ZaphodBytebrox/open-rc-car/docs/anforderungen/karosseriehalter-rammschutz.md

# Anforderungen: Karosseriehalter und Rammschutz

- **Kürzel:** KRS
- **Domäne:** Mechanik
- **Status:** umgesetzt (MECH-KRS-013: Soll vom Nutzer auf ≤ 175 g angehoben; offen nur 🔧 Prototyp)
- **Stand:** 2026-11-13

## Zweck
Vorne und hinten schützt ein Rammschutz Grundplatte, Dämpfer und Querlenkerlaschen bei Frontal- und Heckstößen. Er besteht aus einem steifen Träger aus PC und einem weichen TPU-Puffer davor. Die Puffer laufen unten schräg aus und dienen so auch als Unterfahrschutz für die flache Grundplatte. Auf den Plattenenden sitzen Karosseriepfosten mit Klammern für die Lexan-Karosserie **Neo Scorcher** aus dem TT-02B-Bausatz. Alle Teile nutzen nur die Lochbilder, die Grundplatte und Oberdeck (Fassung 2) auf den Plattenverlängerungen festgelegt haben.

**Meilenstein:** Rammschutz und Karosseriehalter sind konstruiert, in Fusion kollisionsfrei mit Rädern (Federweg, Lenkeinschlag), Dämpfern und Aufhängung und als Druckteile exportiert. Nach Lieferung des Bausatzes werden die Befestigungspunkte und die Höhe der Karosserie gemessen und die Pfosten gegebenenfalls neu gedruckt.

## Schnittstellen
| Zu | Art | Beschreibung |
|---|---|---|
| Skelett (`skelett.md`, Design „open-rc-car-skelett“, aktuelle Version) | mechanisch | Parameter und Hüllkörper per Ableiten: `radstand` 266, `achse_x` 133, Bewegungsräume der Räder `fahrwerk-radraum-*` (vorne X 79,5…186,5 / Y ±71,5…±140,2 mit Lenkeinschlag), `bodenfreiheit` 25, `plattenstaerke` 4 |
| Grundplatte und Oberdeck (`grundplatte-oberdeck.md`, Design „open-rc-car-grundplatte“, **Version 12** aus PR #13) | mechanisch | Plattenenden X ±177 (`gp_ueberstand` 20 mm über die Getriebe hinaus, Nutzerentscheidung 2026-11-13). Eine Lochreihe bei **X ±169,35** (`gp_ende_loch_x`): **Rammschutz** je 2 × M3 an Y ±8 (`gp_ramm_y`), **Karosseriehalter** je 2 × M3 an Y ±22 (`gp_karo_y`). Die Lochachsen liegen 6,85 mm vor bzw. hinter den Dämpferbrücken und 7,65 mm vom Plattenende. Bohrungen Ø 3,2 mit Senkung unten, Senkkopfschrauben von unten, Gewinde im aufgesetzten Teil (Gewindeeinsätze wie Pos. 30). Plattenunterseite Z 25, Oberseite Z 29, Plattenende ±46 mm breit. Alle 8 Löcher eines Endes liegen auf einer X-Linie: Ein Träger braucht für Stoß- und Kippmomente eine Abstützung, z. B. an der Plattenstirn (bis X ±177) oder über alle 4 Löcher (die Dämpferbrücken dürfen nicht berührt werden, MECH-KRS-004). |
| Vorderachse (`vorderachse.md`, Design „open-rc-car-vorderachse“ **v8**) | mechanisch | Die Dämpferbrücke vorne (X 156,5…162,5, ab Z 31) liegt hinter der Lochreihe. Davor liegen die Dämpfer (X 163…181, Y ±37…±59, Z 36…96) und die Querlenkerlaschen bis X 168,5 (Querlenker ab \|Y\| 31,5). Die Sturzstangen liegen bei X 139…150,5, Z 66…87. |
| Hinterachse (`hinterachse.md`, Design „open-rc-car-hinterachse“ v14) | mechanisch | Die Dämpferbrücke hinten (X −162,5…−156,5, Y ±58,7, Z 31…109) liegt vor der Lochreihe. Die Dämpfer (X −176…−156, \|Y\| 44…77, Z 26…109) reichen fast bis zum Plattenende. Halter dürfen die Brücken nicht berühren und müssen neben den Dämpfern bleiben. |
| Karosserie Neo Scorcher (Bausatz 58568) | mechanisch | Lexan-Karosserie aus dem Bausatz, Fahrzeug 380 × 250 mm. Lage und Höhe der Befestigungslöcher sind vorläufig (aus der Bauanleitung) und werden nach Lieferung gemessen. Die Karosserieklammern stammen aus dem Bausatz. |

## Anforderungen
| ID | Priorität | Anforderung | Abnahmekriterium |
|---|---|---|---|
| MECH-KRS-001 | MUSS | Eigenes Fusion-Design „open-rc-car-karosseriehalter-rammschutz“ im Projekt „open-rc-car“, abgeleitet vom Skelett, von der Grundplatte und (für die Prüfung) von Vorder- und Hinterachse. Neue Maße sind Benutzerparameter mit Präfix `kr_` und Kommentar (Quelle, „belegt“, „vorläufig“ oder „abgeleitet“). Alle Karosseriemaße (Lochabstand, Höhe und Lage der Befestigungspunkte vorne und hinten) und die Maße der Klammern sind eigene Parameter. | Parameterliste in Fusion, jeder Parameter mit Kommentar; Skizzen voll bestimmt. Test: `radstand` im Skelett auf 280 mm → Ableitungen aktualisieren ohne Fehler, die Teile folgen den Lochbildern, danach zurück auf 266 mm. Dafür darf das Skelett als zwei neue Versionen gespeichert werden (280 mm, danach wieder 266 mm, maßgleich mit dem Stand davor), wie bei der Hinterachse. |
| MECH-KRS-002 | MUSS | **Rammschutz vorne und hinten** (Nutzerentscheidung 2026-11-10), je aus einem **Träger** aus Prusament PC (PETG für den Test) und einem **Puffer** aus TPU davor. Der Träger sitzt auf dem Rammschutz-Lochbild (±169,35 / ±8) und darf zusätzlich das Karosseriehalter-Lochbild (±169,35 / ±22) nutzen, mit Gewindeeinsätzen. Der Puffer ist am Träger befestigt (verschraubt oder formschlüssig), ohne Gewindeeinsätze im TPU. | Modell: 2 Träger, 2 Puffer auf den Lochbildern, Lochmitten gemessen. Befestigung des Puffers im Schnittbild gezeigt. |
| MECH-KRS-003 | MUSS | **Schutzwirkung:** In der Draufsicht liegen die Dämpfer und Querlenkerlaschen der jeweiligen Achse innerhalb der Pufferbreite. Die Stoßfläche des Puffers liegt **≥ 5 mm vor** (bzw. hinter) allen anderen Teilen des Fahrzeugs außer den Rädern. **Gesamtlänge** über beide Puffer ≤ 380 mm (wie das Neo-Scorcher-Fahrzeug). | Gemessen in Fusion: X der Stoßflächen, X der vordersten bzw. hintersten übrigen Teile, Pufferbreite in Y gegenüber den Dämpfern, Gesamtlänge. |
| MECH-KRS-004 | MUSS | **Kollisionsfreiheit:** Rammschutz und Karosseriepfosten kollidieren nicht mit den Bewegungsräumen der Räder (Federweg, vorne mit vollem Lenkeinschlag), den Dämpfern über den Federweg, Querlenkern, Dämpferbrücken, Sturzstangen und der Lenkung. Die Dämpferbrücken werden nicht berührt. | Interferenz ↔ Skelett, Grundplatte, Vorderachse, Hinterachse: 0 außer an den gewollten Auflageflächen auf der Grundplatte. Mindestabstand ≥ 3 mm zu den Bewegungsräumen der Räder und ≥ 1 mm zu allen anderen Teilen, gemessen und dokumentiert. |
| MECH-KRS-005 | MUSS | **Unterfahrschutz** (Nutzerentscheidung 2026-11-10): Die Puffer laufen unten als Anfahrschräge aus und decken die Stirnkante der Grundplatte vorne bzw. hinten ab, damit das Auto über Kanten gleitet. Kein eigenes Teil unter der Platte. Der tiefste Punkt liegt **nicht unter Z 25** (Bodenfreiheit bleibt erhalten). Schräge ≥ 30° zur Waagerechten. | Gemessen: tiefster Punkt der Puffer Z ≥ 25,0. Winkel der Schräge, Abdeckung der Plattenstirnkante im Schnittbild. |
| MECH-KRS-006 | MUSS | **Karosseriehalter** (Nutzerentscheidung 2026-11-10): vorne und hinten je zwei **Pfosten mit Lochraster für Klammern** (wie TT-02B) für die Neo-Scorcher-Karosserie. Höhe über ein Lochraster einstellbar, mindestens ±6 mm um die Nennhöhe in Schritten ≤ 4 mm. Lage und Nennhöhe vorläufig aus der Bauanleitung als Parameter. Die Pfosten sitzen auf dem Karosseriehalter-Lochbild (±169,35 / ±22) oder am Träger des Rammschutzes. Weichen die Befestigungslöcher der Karosserie davon ab, gleicht ein Querträger bzw. eine Verlängerung am Pfosten das aus, ohne die Grundplatte zu ändern. | Pfostenlage und -höhen gemessen und in `docs/karosseriehalter-rammschutz.md` den vorläufigen Karosseriemaßen gegenübergestellt. Verstellbereich aus dem Lochraster belegt. 🔧 Probemontage der Karosserie nach Lieferung. |
| MECH-KRS-007 | MUSS | **Freiraum für die Karosserie:** Ein vereinfachter Hüllkörper der Karosserie (vorläufig aus Bauanleitung und Produktmaßen, Wandstärke vernachlässigt) wird angelegt und gegen Räder (voller Federweg und Lenkeinschlag), Dämpfer, Dämpferbrücken, Oberdeck, Servo-Saver und Lenkgestänge geprüft. Wo die Hülle unsicher ist, werden die Abstände dokumentiert statt angepasst. | Interferenzliste Karosseriehülle ↔ Fahrzeug in `docs/karosseriehalter-rammschutz.md`, kleinster Abstand je Bereich. 🔧 Probemontage am Prototyp: Karosserie schleift nirgends bei vollem Einfedern und Lenkeinschlag. |
| MECH-KRS-008 | MUSS | **Lasten:** Rammschutz als statische Ersatzlast **200 N frontal mittig** (≈ 10 g bei 2 kg) und **100 N an der Pufferecke** (außermittig, auch 30° schräg). Sicherheitsfaktor ≥ 1,5 für Träger, Schrauben M3, Gewindeeinsätze und Grundplatte am Lochbild. **Sollbruchstelle** ist der Träger, nicht die Grundplatte. TPU-Puffer mit einem Federweg ≥ 5 mm vor der Anlage am Träger. Karosseriepfosten: 20 N quer an der Pfostenspitze (Überschlag) ohne Bruch. | Abschätzung (Biegung, Scherung, Ausreißen der Einsätze, Lochleibung der Grundplatte in PETG/PC) in `docs/karosseriehalter-rammschutz.md`. 🔧 Prototyp: Anfahren gegen eine Wand mit ca. 10 km/h vorne und rückwärts ohne Schaden an Grundplatte, Dämpfern und Querlenkern. |
| MECH-KRS-009 | MUSS | Druckbarkeit: alle Teile auf 256 × 256 × 256 mm (MECH-FZG-003), ohne oder mit wenig Stützmaterial (Druckausrichtung je Teil dokumentiert). Mindestwand 1,2 mm (Träger und Pfosten), TPU-Puffer ≥ 2 mm Wand. Bohrungen +0,2 mm. Material: Träger und Pfosten PETG für den Test, Prusament PC fertig; Puffer TPU (Annahme Shore 95A). | Hüllquader je Teil ≤ 256 mm; Wandstärken gemessen; Druckausrichtung, Material und Toleranzen in `docs/karosseriehalter-rammschutz.md`. 🔧 Slicer-Prüfung durch den Nutzer. |
| MECH-KRS-010 | MUSS | Normteile metrisch M3; jedes neue Teil (Druckteile, Schrauben, Einsätze, Klammern) in `bom/stueckliste.csv` mit Datei bzw. Bezugsquelle. In Pos. 1 die Karosserie nicht mehr als Reserve führen, sondern als genutztes Bausatzteil. | Stückliste geprüft, CSV gültig, jede Zeile mit Datei bzw. Bezugsquelle. |
| MECH-KRS-011 | MUSS | Exporte aus **einer** Design-Version: `cad/fusion/karosseriehalter-rammschutz.f3d`, `cad/step/karosseriehalter-rammschutz.step`, STL je Druckteil in `print/stl/` (z. B. `rammschutz-traeger-vorne/-hinten`, `rammschutz-puffer-vorne/-hinten`, `karosserie-pfosten-vorne/-hinten`). | Dateien im PR (Git LFS). |
| MECH-KRS-012 | SOLL | Wartung (MECH-FZG-010): Der Puffer lässt sich tauschen, ohne den Träger abzuschrauben. Der Träger lässt sich von unten lösen, ohne Dämpferbrücke, Dämpfer oder Querlenker abzubauen. Die Karosserie geht ohne Werkzeug ab (nur Klammern). | Montagefolge in `docs/karosseriehalter-rammschutz.md`. |
| MECH-KRS-013 | SOLL | Masse aller Druckteile ≤ 175 g (bis 2026-11-13 ≤ 80 g, angehoben durch Nutzerentscheidung; 100 % Füllung als obere Grenze, TPU 1,21 g/cm³, PETG 1,27 g/cm³). | Masse aus Fusion dokumentiert. |
| MECH-KRS-014 | SOLL | Die Träger sind möglichst fräsgerecht (2,5D, Innenradien ≥ 1,5 mm), damit sie später aus Alu gefertigt werden können. | Sichtprüfung; Abweichungen begründet. |
| DOC-KRS-001 | MUSS | `docs/karosseriehalter-rammschutz.md`: Aufbau in Fusion, Parameterliste, Schutzwirkung (Maße aus MECH-KRS-003), Interferenz und Abstände, Karosseriehülle, Lasten, Druckhinweise, Montagefolge, **Messpunkte bei Lieferung** (Befestigungslöcher und Höhe der Karosserie, Klammern, TPU-Härte), Vorgaben an spätere Baugruppen (Elektronikhalter: Freiraum unter der Karosserie). Screenshots (iso, vorne, hinten, oben, seitlich mit Karosseriehülle) in `docs/images/`. | Datei vorhanden, Screenshots eingebunden. |
| DOC-KRS-002 | MUSS | `docs/plan.md`: Entscheidungen dieser Anforderung unter „Entscheidungen“; Phase 1 Punkt 6 als umgesetzt markieren (Probemontage offen); offener Punkt „Karosserie“ erledigt (Neo Scorcher aus dem Bausatz). `docs/anforderungen/fahrzeug.md`: offenen Punkt „Karosserie“ abhaken. | Diff der beiden Dateien. |

## Entscheidungen (vom Nutzer)
- 2026-11-10: **Karosserie Neo Scorcher aus dem Bausatz 58568** (Grund: liegt bei, kostet nichts extra und passt zu Radstand und Spur des TT-02B). Befestigungsmaße werden nach Lieferung gemessen.
- 2026-11-10: **Befestigung mit Pfosten und Klammern** wie beim TT-02B, vorne und hinten je zwei Pfosten mit Lochraster für die Höhe (Grund: robust, günstig, passt zu Lexan; Magnete lösen sich bei Sprüngen leichter).
- 2026-11-10: **Rammschutz vorne und hinten** (Grund: Die hinteren Dämpfer ragen 4 mm über die Platte hinaus).
- 2026-11-10: **Rammschutz zweiteilig: Träger aus PC, Puffer aus TPU** (Grund: TPU nimmt die Stoßenergie auf und schont Platte und Schrauben, der Träger nimmt Gewindeeinsätze und Pfosten auf).
- 2026-11-10: **Unterfahrschutz als Schräge im TPU-Puffer**, kein eigenes Teil unter der Platte; die Bodenfreiheit von 25 mm bleibt.
- 2026-11-10: Anforderungsdokument vom Nutzer freigegeben, mit Speichern und Export in Fusion (einschließlich Speichern des Skeletts für den Radstand-Test).
- 2026-11-13 (Rückfrage aus Umsetzung Durchlauf 1): Die alte Lochreihe X ±164,5 lag nur 2,0 mm vor bzw. hinter den Dämpferbrücken, zu wenig für Gewindeeinsätze. **Grundplatte in eigenem PR #13 geändert:** `gp_ueberstand` 20 mm, Lochreihe X ±169,35 (Platte 354 mm lang). Dieser PR baut auf PR #13 auf. Die Vorderachse gilt in v8 (eine Cloud-Version 9 ist unwichtig).
- 2026-11-13 (Rückfrage aus Umsetzung): **Masse-Soll MECH-KRS-013 auf ≤ 175 g angehoben** (vorher ≤ 80 g). Die MUSS-Lasten (200/100 N, Faktor 1,5), die Gesamtlänge ≤ 380 mm und die volle Dämpferbreite erzwingen hohe Träger (171 g mit 100 % Füllung). Verworfen: Lasten senken, Puffer schmaler.

## Annahmen (abgeleitet, noch nicht bestätigt)
- Konstruiert wird wie bei den anderen Baugruppen **mit vorläufigen Maßen**, hier für die Karosserie (Befestigungslöcher, Höhe, Hülle) aus der Bauanleitung und den Produktmaßen 380 × 250 mm. Gemessen wird nach Lieferung.
- Der Drucker kann TPU drucken. Härte Shore 95A (übliches Filament); die Puffer-Steifigkeit wird am Prototyp geprüft.
- Die Karosserieklammern (R-Klammern) liegen dem Bausatz bei. Ersatz als Zukauf in der Stückliste nur, falls nicht.
- Lastannahme 200 N frontal (≈ 10 g) als statische Ersatzlast, weil eine Crash-Simulation nicht verfügbar ist; das Verhalten wird am Prototyp geprüft.
- Gesamtlänge ≤ 380 mm aus dem Neo-Scorcher-Fahrzeug, damit die Karosserie die Puffer nicht verdeckt bzw. nicht übersteht.
- Senkkopfschrauben M3 von unten mit Gewindeeinsätzen (Pos. 30) wie bei allen anderen Teilen auf der Grundplatte.
- Ein Flügel (falls am Neo Scorcher vorhanden) gehört zur Karosserie und braucht keinen eigenen Halter.

## Nicht Teil dieser Anforderung
- Lackieren, Ausschneiden und Bohren der Karosserie (macht der Nutzer nach Lieferung; die Doku nennt die Lochlage)
- Elektronikhalter, Empfänger- und Antennenführung (eigene Anforderung, Plan Phase 1 Punkt 5); hier wird nur der Freiraum unter der Karosserie dokumentiert
- Eigener Unterfahrschutz bzw. Gleitplatten unter der Grundplatte
- Änderungen an Grundplatte, Oberdeck, Vorder- und Hinterachse; passt ein Lochbild nicht, meldet die Umsetzung das zurück
- Messen der Bausatzteile (nach Lieferung, durch den Nutzer)

## Offene Punkte
- keine, die die Umsetzung blockieren
- Nach Lieferung: Befestigungslöcher und Höhe der Karosserie, Klammern und TPU-Härte prüfen, Pfosten gegebenenfalls neu drucken

## Nachweis
Umsetzung in `docs/karosseriehalter-rammschutz.md`, Fusion-Design „open-rc-car-karosseriehalter-rammschutz“ Version 4 (abgeleitet von Skelett v16, Grundplatte v12, Vorderachse v8, Hinterachse v14).

| ID | Status | Nachweis |
|---|---|---|
| MECH-KRS-001 | ✅ erfüllt | Eigenes Design mit 4 Ableitungen; 108 Benutzerparameter `kr_*`, alle mit Kommentar (37 „vorläufig“); alle Karosserie- und Klammermaße eigene Parameter (`kr_karo_*`, `kr_hu_*`, `kr_klammer_*`); 32 Skizzen voll bestimmt, Zeitleiste 80 Elemente ohne Fehler. Test `radstand` 280 mm: Skelett v15, Ableitung ohne Fehler, alle Teile folgen der Lochreihe X ±176,35 (+7,0 mm); zurück auf 266 mm als Skelett v16 (maßgleich mit v14: 155 Parameter, 40 Körper gleich), Ableitung wieder ohne Fehler, alle Werte wie vorher. |
| MECH-KRS-002 | ✅ erfüllt | 2 Träger (PC/PETG), 2 TPU-Puffer. Lochmitten gemessen: Einsätze (±169,35 / ±8,0), Durchgänge der Pfostenschrauben (±169,35 / ±22,0); Abstützung an der Plattenstirn und über alle 4 Löcher. Puffer: 2 × M3 × 8 von oben in Einsätze im Mittelsteg des Trägers, Deckel formschlüssig über dem Balken, keine Einsätze im TPU; Schnittbilder `karosseriehalter-rammschutz-schnitt-puffer*.png`. |
| MECH-KRS-003 | ✅ erfüllt | Stoßfläche vorne X 191,8, 11,5 mm vor den Dämpfern (X 180,3, vorderstes übriges Teil); hinten X −187,8, 10,8 mm hinter der Platte (−177,0) bzw. 11,6 mm hinter den Dämpfern (−176,2). Pufferbreite ±61 / ±78 gegenüber Dämpfern ±58,8 / ±77,2 und Dämpferlaschen (Augen ±52,0 / ±69,8). Gesamtlänge 379,6 mm ≤ 380. |
| MECH-KRS-004 | ✅ erfüllt | Interferenz in Konstruktionslage und in 9 Stellungen vorne (Federweg × Lenkeinschlag) bzw. 3 Stellungen hinten: 0 außer Auflageflächen. Mindestabstände: Räder 3,29 mm (Träger hinten, ausgefedert), Bewegungsräume Skelett ≥ 6,41 mm; Dämpfer 1,05 mm, Dämpferbrücken 3,00 mm (Träger) bzw. 2,85 mm (Pfosten), Querlenker ≥ 8,80 mm, Sturzstangen ≥ 9,74 mm, Lenkung > 40 mm. |
| MECH-KRS-005 | ✅ erfüllt | Tiefster Punkt der Puffer Z 25,0 (gemessen); Schräge 45,0° (Flächennormalen); Stirnkante (Z 25…29, Y ±46) in der Front- und Heckansicht vom Puffer abgedeckt (Schnittbilder, Ansichten vorne/hinten). |
| MECH-KRS-006 | ✅ erfüllt, 🔧 Probemontage | Je 2 Pfosten 8 × 8 mm auf dem Karosseriehalter-Lochbild (±169,35 / ±22), 5 Klammerlöcher Teilung 4 mm: Verstellbereich ±8 mm (Soll ±6, Schritt ≤ 4). Nennhöhe vorläufig 105 / 116 mm, Klammerlöcher gemessen Z 98,5…114,5 bzw. 109,5…125,5; Gegenüberstellung mit den vorläufigen Karosseriemaßen in der Doku. 🔧 Probemontage nach Lieferung. |
| MECH-KRS-007 | ✅ erfüllt, 🔧 Probemontage | Vorläufige Karosseriehülle angelegt; Interferenzliste und kleinste Abstände je Bereich in der Doku (Räder ≥ 7,01 / 12,52 mm, Sturzstangen ≥ 4,32 mm, Lenkgestänge 4,89 mm, Dämpfer ≥ 6,12 mm, Brücken ≥ 6,88 mm, Oberdeck 26,5 mm, Servo-Saver 22,2 mm); gewollt nur Pfosten durch die Karosserielöcher und Akku-Entnahmeweg. 🔧 Probemontage. |
| MECH-KRS-008 | ✅ erfüllt (Abschätzung), 🔧 Prototyp | Abschätzung in der Doku: Eckenlast 100 N Balken vorne Sicherheit 1,51 (PETG) / 1,93 (PC), hinten 1,60 / 2,04; 30° schräg ≥ 1,73; frontal 200 N ≥ 2,62; Lochleibung Grundplatte 4,2 MPa, Anlage an der Stirn < 1 MPa → Sollbruchstelle Träger; Pfosten 20 N ≥ 2,17. TPU-Federweg 5,0 mm. 🔧 Wandtest mit ca. 10 km/h, Ausreißkraft der Pfosteneinsätze. |
| MECH-KRS-009 | ✅ erfüllt, 🔧 Slicer | Hüllquader ≤ 19,3 × 156 × 94 mm; Mindestwand Träger/Pfosten 1,5 mm (Einsatz im Steg) bzw. 1,85 mm, TPU 2,0 mm; Bohrungen +0,2 mm; Druckausrichtung ohne Stützen, Material und Toleranzen in der Doku. 🔧 Slicer-Prüfung durch den Nutzer. |
| MECH-KRS-010 | ✅ erfüllt | Stückliste Pos. 81–88 neu (Träger, Puffer, Pfosten, Karosserie, Klammern), Pos. 1 (Karosserie genutzt), Pos. 17, 24, 27, 30, 80 ergänzt; CSV mit 18 Spalten je Zeile geprüft. |
| MECH-KRS-011 | ✅ erfüllt | Aus Design-Version 4: `cad/fusion/karosseriehalter-rammschutz.f3d`, `cad/step/karosseriehalter-rammschutz.step` (6 Komponenten, 8 Körper), 6 STL (`rammschutz-traeger-vorne/-hinten`, `rammschutz-puffer-vorne/-hinten`, `karosserie-pfosten-vorne/-hinten`). |
| MECH-KRS-012 | ✅ erfüllt (SOLL) | Montagefolge in der Doku: Puffer mit 2 Schrauben oben tauschbar, Träger mit 4 Schrauben von unten lösbar ohne Brücke, Dämpfer oder Querlenker, Karosserie nur mit Klammern. |
| MECH-KRS-013 | ✅ erfüllt (SOLL, Soll ≤ 175 g seit 2026-11-13) | 171,0 g (PETG/TPU, 100 %) ≤ 175 g; Begründung in der Doku (Masse). |
| MECH-KRS-014 | ✅ erfüllt (SOLL) | Träger 2,5D, senkrechte Innenecken R 2,0 mm (Prüfskript: keine scharfen senkrechten Innenkanten), Taschen mit Freistich Ø 3, keine Hinterschnitte. |
| DOC-KRS-001 | ✅ erfüllt | `docs/karosseriehalter-rammschutz.md` mit allen geforderten Abschnitten und 9 Bildern in `docs/images/`. |
| DOC-KRS-002 | ✅ erfüllt | `docs/plan.md`: Entscheidung 2026-11-10, Phase 1 Punkt 6 umgesetzt (Probemontage offen), Karosserie erledigt; `docs/anforderungen/fahrzeug.md`: Karosserie abgehakt. |
