ZaphodBytebrox/open-rc-car/docs/anforderungen/grundplatte-oberdeck.md

# Anforderungen: Grundplatte und Oberdeck

- **Kürzel:** CHA
- **Domäne:** Mechanik
- **Status:** umgesetzt (Review 1, Fügespiel und Änderung 2026-11-13 eingearbeitet; offen 🔧 Prototyp, ⏳ Phase 3)
- **Stand:** 2026-11-13

> **Fassung 2 (Plattformwechsel):** Die erste Fassung (umgesetzt am 2026-10-27/28 in PR #6, Commit `0a0ae17`) war auf das Skelett mit dem Layout des TLR 22X-4 aufgebaut. Seit dem 2026-10-28 ist der **Tamiya TT-02B** die Spenderplattform, und das Skelett ist darauf umgestellt (Fassung 2, Design-Version 10). Grundplatte und Oberdeck werden in PR #6 auf dem neuen Skelett **neu aufgebaut**. Die alte Fassung mit Nachweis steht in der Git-Historie (`git show 0a0ae17:docs/anforderungen/grundplatte-oberdeck.md`) und kann als Vorlage dienen (Prüfskripte, Schnittstellenblatt).

## Zweck
Die Grundplatte trägt alle Baugruppen des Fahrzeugs, das Oberdeck macht sie steif. Beide legen jetzt die **Schnittstellen (Lochbilder) aller späteren Baugruppen** fest: Hinterachse, Mittelantrieb, Vorderachse und Lenkung, Elektronik, Akku, Karosseriehalter und Rammschutz. Die Grundplatte wird für den Druck zweiteilig gebaut und ist zugleich fräsgerecht für die spätere einteilige Aluversion.

**Meilenstein:** Grundplatte (2 Teile), Oberdeck, Mittelstütze und Akkuanschläge sind gedruckt. Eine Probemontage mit den vorhandenen Zukauf- und Bausatzteilen zeigt, dass Lochbilder, Akkuschacht und Elektronik-Raster passen.

## Schnittstellen
| Zu | Art | Beschreibung |
|---|---|---|
| Skelett (`skelett.md` Fassung 2, Design „open-rc-car-skelett“ v10) | mechanisch | Parameter, Bezugsebenen und Hüllkörper per Ableiten (Derive). Umriss 314 × 132 mm (X −157…157), Unterkante Z = 25 mm, `plattenstaerke` 4 mm, Trennstelle `teilung_x` = 0, Überlappung `teilung_ueberlappung` = 30 mm (Stoß X −15…15). |
| Gesamtfahrzeug (`fahrzeug.md`) | mechanisch | MECH-FZG-002 (4WD-Bauraum), -003 (Bauraum 256 mm), -004 (fräsgerecht), -008 (Akkuwechsel), -009 (Elektronik-Raster), -010 (Verschleißteile tauschbar), -011 (Normteile M3) |
| Hinterachse (Getriebegehäuse, Querlenkerböcke) | mechanisch | Lochbild Getriebe und je 2 Querlenkerböcke neben dem Getriebe (vor und hinter der Achse) auf der Grundplatte; Oberdeck hinten auf dem Getriebegehäuse |
| Vorderachse 4WD (Getriebegehäuse) und Lenkung (Servohalter, Lenkhebelsystem, Querlenkerböcke) | mechanisch | Lochbilder Getriebe, Servohalter, 2 Lagerböcke des Lenkhebelsystems und je 2 Querlenkerböcke; Oberdeck vorne auf dem Getriebegehäuse |
| Mittelantrieb (Motorhalter, Zahnradabdeckung, Rutschkupplung) | mechanisch | Lochbild Motorhalter (Motor hinten rechts am Hinterachsgetriebe, Layout TT-02B); Zahnradabdeckung am Motorhalter oder Getriebe. **Kein Mittelschott** (entfällt im TT-02B-Layout). |
| Elektronikhalter (Adapterplatten, Akkubügel) | mechanisch | M3-Raster 10 × 10 mm rechts; Lochbild Bügelpfosten |
| Karosseriehalter und Rammschutz | mechanisch | Lochbilder auf den verlängerten Plattenenden vorne und hinten |
| Zukauf- und Bausatzteile | mechanisch | Hüllkörper aus dem Skelett: Akku 138 × 46 × 25 (Y 12…58), XT60 vor dem Akku, Regler, UBEC, Empfänger rechts, Servo vorne rechts, Motor hinten rechts, Kardanwelle E1 Y ±10 / Z 46,6…66,6, Zahnradabdeckung bis Z 83,2, Getriebe bis Z 80,6 |

## Anforderungen
| ID | Priorität | Anforderung | Abnahmekriterium |
|---|---|---|---|
| MECH-CHA-001 | MUSS | Bestehendes Fusion-Design „open-rc-car-grundplatte“ im Projekt „open-rc-car“ wird als **neue Version** umgebaut (kein neues Design). Die Ableitung zeigt auf „open-rc-car-skelett“ **v10**. Parameter, Bezugsebenen und benötigte Hüllkörper kommen per Ableiten, nicht neu eingegeben. Neue Maße (Lochbilder, Raster, Oberdeck, Stoß, Verlängerung, Böcke, Mittelstütze) sind Benutzerparameter mit Präfix (`gp_`, `od_`, `ms_`, `raster_`, `akku_`, `stoss_`, `ql_`, `lk_`) und Kommentar (Quelle bzw. „vorläufig“). Parameter, die nur zum alten Layout gehörten (z. B. Mittelschott-Lochbild), werden entfernt. | Parameterliste in Fusion; Ableitung im Browser zeigt v10. Test: `radstand` im Skelett auf 280 mm → Ableitung aktualisieren → Grundplatte, Oberdeck, Mittelstütze und Lochbilder folgen ohne Fehler in der Zeitleiste (Screenshot), danach zurücksetzen. |
| MECH-CHA-002 | MUSS | Umriss der Grundplatte = Skelett-Umriss (314 × 132 mm) **plus** (a) Akkuschacht: links neben dem Akku so verbreitert, dass Anschläge mit 1 mm Spiel und Bügelpfosten Platz haben (wie Entscheidung 2026-10-27, Parameter `gp_`/`akku_`); (b) **Verlängerung** vorne und hinten über die Getriebe hinaus um `gp_ueberstand` (**20 mm**, Nutzerentscheidung 2026-11-13; vorher vorläufig 12–15 mm) für Rammschutz und Karosseriehalter; (c) Flächen für die **Querlenkerböcke** neben den Getrieben (MECH-CHA-020). Unterkante Z = `bodenfreiheit`, Dicke `plattenstaerke` = 4 mm. Abstand zu den Bewegungsräumen der Räder (`fahrwerk-radraum-*`) ≥ 5 mm, zu den Bewegungsräumen von Antriebswellen und Radachsen (`antrieb-wellenraum-*`) ≥ 3 mm. | Hüllquader gemessen und dokumentiert (Länge = 314 + 2 × `gp_ueberstand`, Breite), Dicke 4 mm. Interferenzprüfung gegen alle Bewegungsräume: 0 Überschneidungen, Mindestabstände gemessen. |
| MECH-CHA-003 | MUSS | Druckvariante: Grundplatte zweiteilig, Stoß bei `teilung_x` = 0 mit Halbüberlappung 30 mm (je Teil halbe Plattenstärke, hinten unten, vorne oben). Verbindung mit mindestens 6 × M3, Senkkopf von unten; die Schrauben der Mittelstütze (MECH-CHA-021) und der Akkuanschläge dürfen mitzählen, wenn sie durch beide Lagen gehen. Unter Akku und Regler steht oben nichts über (LiPo-Schutz, MECH-CHA-010); Muttern oder Schraubenenden auf der Oberseite kollidieren mit keinem Hüllkörper. | Beide Teile einschließlich Überlappung ≤ 250 × 250 mm. Anzahl Schrauben durch beide Lagen ≥ 6. Unterseite im Stoß flach. Interferenzprüfung Muttern/Schraubenenden ↔ Skelett: 0 Überschneidungen. |
| MECH-CHA-004 | MUSS | Aluvariante: Grundplatte zusätzlich als **einteiliger** Körper `grundplatte-alu` aus derselben Kontur mit denselben Lochbildern (ohne Stoß), als eigenes STEP. | Prüfskript: Lochpositionen Alu = Druck ohne reine Stoßbohrungen. STEP mit 1 Körper. |
| MECH-CHA-005 | MUSS | Fräsgerecht (MECH-FZG-004) für Aluvariante und Oberdeck: 2,5D, Innenradien ≥ 1,5 mm, keine Hinterschnitte; erlaubt sind Durchgangsbohrungen, 90°-Senkungen und Taschen von einer Seite. Bohr-NC, Senk-Operation und Fräs-Simulation werden in Phase 3 nachgeholt (Entscheidungen 2026-10-28, gelten weiter). | Prüfskript: Innenradien ≥ 1,5 mm, Flächen parallel/senkrecht zur Plattenebene außer Senkungen. CAM-Setup mit 2D-Kontur (Ø 3 mm) für `grundplatte-alu` ohne Fehler berechnet. Bohren, Senken, Simulation: ⏳ Phase 3. |
| MECH-CHA-006 | MUSS | Plattenstärke im Druck wie Alu: Grundplatte 4 mm, Oberdeck `od_staerke` (vorläufig 3 mm). Keine Rippen, keine Druck-Sondergeometrie außer dem Stoß. | Messen in Fusion. |
| MECH-CHA-007 | MUSS | Lochbilder als Parameter, Lage aus den Skelett-Hüllkörpern: Hinterachsgetriebe (≥ 4 × M3), Vorderachsgetriebe 4WD (≥ 4 × M3), Motorhalter (≥ 3 × M3, Motor hinten rechts), Servohalter (≥ 4 × M3), Querlenkerböcke (MECH-CHA-020), Lenkhebelsystem (MECH-CHA-022), Mittelstütze (MECH-CHA-021), Akkuanschläge und Bügelpfosten (MECH-CHA-010), Rammschutz und Karosseriehalter vorne und hinten auf der Verlängerung (je ≥ 2 × M3, von unten frei zugänglich); deren Lochreihe liegt so, dass die Lochachsen **≥ 4,2 mm** vor bzw. hinter den Dämpferbrücken der Vorder- und Hinterachse liegen (X ±162,5; Platz für Gewindeeinsatz Ø 4 + Wand 1,2 + Abstand 1) und den Randabstand ≥ 5 mm zum Plattenende einhalten (Nutzerentscheidung 2026-11-13). Jedes Lochbild steht in `docs/grundplatte-oberdeck.md` mit Koordinaten und Parameter (Schnittstellenblatt). | Liste in `docs/grundplatte-oberdeck.md` mit Lochanzahl, Koordinaten und Parameter je Baugruppe. Screenshot von unten. Abstand Lochachse Rammschutz/Karosseriehalter ↔ Dämpferbrücke vorne und hinten in Fusion gemessen (≥ 4,2 mm). |
| MECH-CHA-008 | MUSS | Befestigung einheitlich: Bohrung Ø 3,2 mm mit 90°-Senkung unten für M3-Senkkopf (ISO 10642), Schraube von unten, Gewinde im aufgesetzten Teil (Druck: Gewindeeinsatz, Alu: geschnitten). Unterseite ohne vorstehende Teile. Randabstand Lochmitte ≥ 5 mm, Lochabstand ≥ 8 mm. **Ausnahme** (Nutzerentscheidung 2026-10-31): an den Stufenflächen des Stoßes der Druckteile, die das Fügespiel `stoss_spiel` = 0,2 mm bekommen, gilt Randabstand ≥ 4,8 mm; die Wand zwischen Senkung und Stufe bleibt ≥ 1,2 mm. Die Aluvariante bleibt bei ≥ 5 mm. | Prüfskript: alle Bohrungen 3,2 mm mit Senkung, Rand- und Lochabstände eingehalten (an den Stoßstufen ≥ 4,8 mm, Wand Senkung ↔ Stufe ≥ 1,2 mm). |
| MECH-CHA-009 | MUSS | Elektronik-Raster (MECH-FZG-009): M3-Raster `raster_teilung` = 10 mm im Elektronikbereich rechts (Regler, UBEC, Empfänger), Bohrungen nach MECH-CHA-008, im gleichen Takt über den Stoß. Kein Rasterloch kollidiert mit Motor, Motorhalter oder Servohalter. | Raster 10 mm durchgehend, beide Druckteile im gleichen Takt. Je Gerät ≥ 4 Rasterlöcher unter seinem Hüllkörper. |
| MECH-CHA-010 | MUSS | Akkuschacht (MECH-FZG-008, MECH-SKE-015): Lage des Akkus durch verschraubte Anschläge (Druckteile, links/rechts und vorne/hinten), Spiel 1 mm je Seite zu 138 × 46 mm. Der vordere Anschlag liegt neben dem XT60-Hüllkörper, nicht davor. Lochbild für die Pfosten eines Akkubügels mit Schnellverschluss; der vordere Pfosten ersetzt den vorderen Anschlag (Entscheidung 2026-10-28, gilt weiter). Entnahmeweg nach oben frei (kein Oberdeck, keine Anschläge darin). Keine scharfen Kanten oder Schraubenenden zum Akku hin (LiPo-Schutz). | Interferenz Anschläge ↔ Akku und XT60: 0; Spiel 1,0 mm je Seite gemessen. Entnahmeweg ohne Überschneidung. Kanten zum Akku verrundet ≥ 1 mm. |
| MECH-CHA-011 | MUSS | Oberdeck mittig längs: flache 2,5D-Platte über der Kardanwelle, liegt hinten auf dem Hinterachsgetriebe, vorne auf dem Vorderachsgetriebe und in der Mitte auf der Mittelstütze (MECH-CHA-021), je Verbindung ≥ 2 × M3. Einteilig druckbar. Lässt Akku-Entnahmeweg, Motor, Regler, Servo und Zahnradabdeckung frei; Abstand zu allen Hüllkörpern ≥ 1 mm. Die Auflagehöhe ist die Vorgabe für Getriebegehäuse und Mittelstütze. | Hüllquader ≤ 250 × 250 mm. Interferenzprüfung gegen alle Skelett-Hüllkörper und Bewegungsräume: 0, Mindestabstand ≥ 1 mm. Auflagehöhe in `docs/grundplatte-oberdeck.md`. |
| MECH-CHA-012 | MUSS | Schutz vor drehenden Teilen: Grundplatte und Oberdeck lassen den Bauraum `mittelantrieb-zahnradabdeckung` frei; die Abdeckung hat einen benannten Befestigungspunkt (Lochbild Motorhalter oder Getriebegehäuse). | Interferenz Grundplatte/Oberdeck ↔ Zahnradabdeckung: 0. Befestigungspunkt im Schnittstellenblatt. |
| MECH-CHA-013 | MUSS | Druckbarkeit: alle Teile flach liegend ohne Stützmaterial druckbar, Mindestwandstärke 1,2 mm für seitliche Stege und Wände (Rand unter einem Senkkegel in der 2-mm-Lage zählt nicht als Wand, Entscheidung 2026-10-28), Bohrungen +0,2 mm. Material PETG für die Probemontage, Prusament PC für das fertige Modell; Konstruktion gilt für beide. | Druckausrichtung und Wandstärken in `docs/grundplatte-oberdeck.md`. STL je Druckteil, Hüllquader ≤ 256 × 256 mm; Slicer-Prüfung 🔧 durch den Nutzer, falls kein Slicer verfügbar. |
| MECH-CHA-014 | MUSS | Exporte und Stückliste aus **einer** Design-Version: `cad/fusion/chassis-grundplatte-oberdeck.f3d`, `cad/step/chassis-grundplatte-oberdeck.step` (Druckteile), `cad/step/chassis-grundplatte-alu.step`, STL je Druckteil in `print/stl/` (`chassis-grundplatte-hinten`, `-vorne`, `chassis-oberdeck`, `chassis-mittelstuetze`, `chassis-akkuanschlag-*`). Skelett-Exporte nur erneuern, wenn das Skelett gespeichert wurde. `bom/stueckliste.csv`: Druckteile (Pos. 41, 42, neu Mittelstütze, Akkuanschläge, Aluvariante), Schrauben, Muttern, Gewindeeinsätze; Pos. 47 Mittelschott als entfallen markieren. | Dateien im PR (LFS), Stückliste geprüft. |
| MECH-CHA-015 | MUSS | Probemontage (🙋 Nutzer): Teile in PETG drucken und mit den vorhandenen Teilen montieren. | 🔧 am Prototyp: Stoß ohne Versatz > 0,3 mm; Akku sitzt im Schacht und lässt sich entnehmen; Lochbilder und Raster treffen M3-Schrauben ohne Nacharbeit; Ergebnis und Fotos in `docs/grundplatte-oberdeck.md`. |
| MECH-CHA-016 | SOLL | Steifigkeit: Durchbiegung der verschraubten Grundplatte mit Oberdeck und Mittelstütze in PETG unter 20 N in der Mitte (Auflage an beiden Achsen) ≤ 2 mm. | 🔧 am Prototyp; Fusion-Simulation als Abschätzung, wenn verfügbar. |
| MECH-CHA-017 | SOLL | Masse Grundplatte + Oberdeck + Mittelstütze + Anschläge im Druck ≤ 255 g (PETG, 100 % Füllung als obere Grenze; bis 2026-11-13 ≤ 250 g, angehoben durch Nutzerentscheidung wegen des Überstands 20 mm). | Masse aus Fusion in `docs/grundplatte-oberdeck.md`. |
| MECH-CHA-018 | SOLL | Verschleißteile tauschbar (MECH-FZG-010): Querlenkerböcke, Lenkhebel-Lagerböcke, Servohalter und Motorhalter lassen sich lösen, ohne die Grundplatte zu zerlegen, ein Getriebegehäuse abzubauen oder das Oberdeck abzunehmen. | Sichtprüfung: alle zugehörigen Schrauben von unten erreichbar, keine Bock-Fußfläche unter einem Getriebe- oder Oberdeck-Hüllkörper. |
| MECH-CHA-019 | KANN | Erleichterungstaschen in Bereichen ohne Lochbild und Auflage (fräsgerecht, Radien ≥ 1,5 mm). | Sichtprüfung. |
| MECH-CHA-020 | MUSS | **Querlenkerböcke auf der Platte** (Nutzerentscheidung 2026-10-31): je Achse 4 Böcke, links und rechts je einer vor und einer hinter der Achse, **neben** dem Getriebegehäuse (nicht darunter). Je Bock ein Lochbild ≥ 2 × M3 und eine reservierte Fußfläche (Parameter `ql_`). Fußfläche und Lochbild kollidieren nicht mit Getriebe, Diff-Bechern, Dämpfern, Zahnradabdeckung, Servo, Akku, Elektronik und halten die Abstände zu den Bewegungsräumen aus MECH-CHA-002 ein. Die Lage ist vorläufig, bis „Hinterachse“ bzw. „Vorderachse“ die Aufhängungsgeometrie festlegen; die Anlenkachse ist parallel zu X angenommen. | Lochbilder und Fußflächen im Schnittstellenblatt mit Koordinaten. Interferenzprüfung Fußflächen (als Quader bis Unterkante Diff-Becher bzw. 15 mm hoch) ↔ Skelett: 0. |
| MECH-CHA-021 | MUSS | **Mittelstütze** (neues Druckteil, Ersatz für das Mittelschott als Auflage des Oberdecks, Nutzerentscheidung 2026-10-31): steht rechts neben der Kardanwelle im Bereich des Stoßes (X ≈ `teilung_x`), von unten mit ≥ 4 × M3 durch beide Lagen der Überlappung verschraubt (klemmt den Stoß), oben ≥ 2 × M3 zum Oberdeck. Gewindeeinsätze in der Stütze. Abstand zu Kardanwelle, Regler, Motor und Akku-Entnahmeweg ≥ 1 mm. Flach liegend ohne Stützmaterial druckbar. | Interferenzprüfung Mittelstütze ↔ Skelett: 0, Mindestabstand ≥ 1 mm. Schrauben durch beide Lagen gezählt. Hüllquader und Druckausrichtung dokumentiert. |
| MECH-CHA-022 | MUSS | **Lochbild Lenkhebelsystem** (Nutzerentscheidung 2026-10-31): zwei Lagerböcke für das Lenkhebelsystem mit Servo-Saver (Stückliste Pos. 52), je ≥ 2 × M3, Lage vorläufig im freien Bauraum vorne (z. B. vor dem Vorderachsgetriebe auf der Verlängerung oder neben dem Servo), Parameter `lk_`. Reservierte Fußfläche kollidiert mit keinem Hüllkörper (inkl. Rad- und Wellenraum mit Lenkeinschlag). Die Lage ist vorläufig, bis „Vorderachse und Lenkung“ die Ackermann-Geometrie festlegt. | Lochbild und Fußfläche im Schnittstellenblatt mit Koordinaten und Begründung der Lage. Interferenzprüfung: 0. |
| DOC-CHA-001 | MUSS | `docs/grundplatte-oberdeck.md` neu für Fassung 2: Schnittstellenblatt mit allen Lochbildern und Koordinaten, Parameterliste, Stoß, Oberdeck-Auflagehöhe, Mittelstütze, Vorgaben an Hinterachse, Vorderachse/Lenkung, Mittelantrieb und Elektronikhalter, Druckhinweise, Screenshots oben/unten/iso in `docs/images/` (alte Bilder ersetzt), Abschnitt Probemontage (vom Nutzer auszufüllen). Kein Verweis mehr auf TLR-Maße außer in einem Abschnitt „Historie“. | Datei vorhanden, Screenshots eingebunden. |
| DOC-CHA-002 | MUSS | `docs/plan.md`: Entscheidungen dieser Fassung unter „Entscheidungen“; offenen Punkt „Grundplatte/Oberdeck (PR #6) auf dem neuen Skelett neu aufbauen“ abhaken; Phase 1 Punkt 1 als umgesetzt markieren (Probemontage offen); Phase-3-Punkte zum CAM (Bohr-NC, Senken, Simulation) erhalten. | Diff von `docs/plan.md` |

## Entscheidungen (vom Nutzer)
Aus Fassung 1, gelten weiter:
- 2026-10-27: Die Grundplatte legt die Lochbilder aller Baugruppen jetzt fest (aus den Skelett-Hüllkörpern, als Parameter). Spätere Baugruppen halten sich daran. (Grund: Platte ist sofort fertig und druckbar.)
- 2026-10-27: Druck-Grundplatte 4 mm wie Alu, keine Rippen, kein Aufdicken. (Grund: Alu-Maße 1:1 testen; Steifigkeit kommt vom Oberdeck.)
- 2026-10-27: Akku mit Bügel und Schnellverschluss halten. Die Grundplatte bekommt das Lochbild für die Pfosten; der Bügel kommt mit „Elektronikhalter“.
- 2026-10-27: Material: PETG zum Testen, Prusament PC für das fertige Modell, wenn steif genug.
- 2026-10-27: Oberdeck mittig längs, Akku links und Elektronik rechts von oben frei.
- 2026-10-27: Stoß als Halbüberlappung mit M3-Senkschrauben von unten.
- 2026-10-27: Elektronik-Raster 10 × 10 mm, Senkkopf M3 von unten in Gewindeeinsätze der Adapterplatten.
- 2026-10-27: Grundplatte im Akkubereich nach links verbreitern, damit Anschläge und Bügelpfosten Platz haben; Skelett bleibt maßlich unverändert, neue Maße sind Parameter der Grundplatte.
- 2026-10-27: Für das Ableiten dürfen im Skelett alle Benutzerparameter als Favorit markiert und das Skelett als neue Version gespeichert werden (auch für Parametertests). Maße im Skelett werden nicht geändert.
- 2026-10-28: Der vordere Pfosten des Akkubügels ersetzt den vorderen Akkuanschlag und übernimmt dessen Anschlagfunktion (1 mm Spiel). Vorgabe für „Elektronikhalter“.
- 2026-10-28: CAM-Simulation, Senk-Operation und vollständiges Bohr-NC der Aluvariante werden in Phase 3 nachgeholt. Hier genügen Prüfskript (2,5D, Radien) und fehlerfreie Kontur-Operation.
- 2026-10-28: Rand unter dem Senkkegel in der 2-mm-Lage des Stoßes wird akzeptiert (Mindestwand gilt für seitliche Stege).

Neu in Fassung 2:
- 2026-10-31: Grundplatte und Oberdeck werden **in PR #6 auf dem Branch `mech/grundplatte-oberdeck`** auf dem TT-02B-Skelett (v10) neu aufgebaut; der Branch wurde auf den aktuellen `main` gesetzt, der alte Stand bleibt als Commit `0a0ae17` in der Historie.
- 2026-10-31: **Querlenkerböcke als eigene Teile auf der Platte**, je Achse 2 Böcke vor und hinter der Achse, neben dem Getriebe (statt Anlenkung am Getriebegehäuse wie beim TT-02B). Die Anlenkpunkte werden damit jetzt vorläufig festgelegt.
- 2026-10-31: **Oberdeck auf beiden Getrieben plus Mittelstütze** rechts neben der Kardanwelle am Stoß (neues Druckteil, ersetzt das entfallene Mittelschott als Auflage und klemmt den Stoß).
- 2026-10-31: **Plattenenden vorne und hinten über die Getriebe hinaus verlängert**, dort Lochbilder für Rammschutz und Karosseriehalter (Crashlasten in die Platte).
- 2026-10-31: **Eigenes Lochbild für das Lenkhebelsystem** auf der Platte, jetzt vorläufig festgelegt (Risiko Neudruck der vorderen Platte bei geänderter Ackermann-Geometrie in Kauf genommen).
- 2026-10-31: Anforderungsdokument (Fassung 2) vom Nutzer freigegeben, mit Speichern und Export in Fusion (inkl. Annahme Abstand ≥ 3 mm zu den Wellenräumen).
- 2026-10-31 (Rückfrage nach Umsetzung Durchlauf 1): Für den Parametertest aus MECH-CHA-001 darf das Skelett „open-rc-car-skelett“ als neue Versionen gespeichert werden (v11 mit `radstand` 280 mm, v12 zurückgesetzt auf 266 mm). Die Maße des Skeletts bleiben danach unverändert; die Ableitung der Grundplatte darf auf die zurückgesetzte Version zeigen oder auf v10 zurückgestellt werden. Die Skelett-Exporte werden nur erneuert, wenn sich die Geometrie ändert.

- 2026-10-31 (Rückfrage nach Einarbeitung Review 1): **Fügespiel am Stoß** 0,2 mm (`stoss_spiel`) an den senkrechten Stufenflächen der Druckteile. Weil Raster, Mittelstütze und Anschläge Löcher genau 5,0 mm vor bzw. hinter den Stufen haben, gilt dort ein Randabstand ≥ 4,8 mm als Ausnahme von MECH-CHA-008 (Wand Senkung ↔ Stufe ca. 1,35 mm ≥ 1,2 mm). Aluvariante unverändert. Verworfen: Rasterspalten auslassen; ohne Spiel nacharbeiten. (Grund: Stoß soll ohne Klemmen fügen, Raster bleibt durchgehend.)

Änderung 2026-11-13 (aus der Umsetzung „Karosseriehalter und Rammschutz“):
- 2026-11-13: **`gp_ueberstand` 20 mm statt 15 mm, Lochreihe für Rammschutz und Karosseriehalter nach außen verlegt.** Die Lochachsen lagen bei X ±164,5 nur 2,0 mm vor bzw. hinter den Dämpferbrücken (X ±162,5); ein Gewindeeinsatz braucht 4,2 mm. Neue Lage: Abstand zur Brücke ≥ 4,2 mm, Randabstand ≥ 5 mm, genaue Lage legt die Umsetzung als Parameter fest. Grundplatte damit ca. 354 mm lang. Verworfen: Dämpferbrücken ausklinken (schwächt die Brücken, ändert zwei Baugruppen); Lochreihe nur verlegen ohne längere Platte (zu wenig Platz für den Träger). Masse-Soll MECH-CHA-017 auf ≤ 255 g angehoben (251,6 g mit 100 % Füllung). Gedruckt war noch nichts. Freigabe mit Speichern und Export in Fusion; das Design „open-rc-car-vorderachse“ darf ohne Speichern geschlossen werden (ungespeicherte v9 verwerfen, v8 gilt).

## Annahmen (abgeleitet, noch nicht bestätigt)
- **Abstand zu den Wellenräumen ≥ 3 mm** statt 5 mm (zu den Radräumen bleibt ≥ 5 mm). Grund: Vor der Hinterachse liegt zwischen Wellenraum (bis X −122,7) und Dämpfer bzw. Zahnradabdeckung (ab X −119,25 bzw. −109) nur ein schmales Fenster für die vorderen Böcke; die Bewegungsräume enthalten bereits den Zuschlag und den eher zu großen Federweg 35 mm.
- Ist für einen Bock neben dem Getriebe nach diesen Regeln kein Platz, meldet die Umsetzung das zurück, statt ihn unter das Getriebe zu legen.
- Die Fußfläche eines Querlenker- oder Lenkhebelbocks wird als Quader modelliert, damit Kollisionen prüfbar sind; die echte Form kommt mit der jeweiligen Achse.
- Die Lage der Böcke ist ein Parameter; eine spätere Änderung bedeutet einen Neudruck der betroffenen Plattenhälfte.
- Oberdeck über der Zahnradabdeckung (Oberkante Z 83,2) → Unterkante Oberdeck ≥ 84,2 mm; die Getriebegehäuse reichen bis zur Auflagehöhe. Die Zahnradabdeckung bleibt für den Ritzelwechsel zugänglich (z. B. seitlicher Deckel); das ist eine Vorgabe an „Mittelantrieb“.
- Oberdeck seitlich zwischen Akku-Entnahmeweg (ab Y 12) und rechter Seite; Breite und Form wählt die Umsetzung (2,5D, Radien ≥ 1,5 mm).
- Mittelstütze im Fenster zwischen Kardanwelle (Y −10) und Regler (Y −32) bei X ≈ −15…15; Motor beginnt erst bei X −23.
- Unter dem Akku (Stoß X −15…15, Y 12…58) steht nichts über; dort klemmen die Schrauben der Akkuanschläge links den Stoß wie in Fassung 1.
- Dämpferbrücken sitzen auf den Getriebegehäusen und brauchen kein Lochbild in der Grundplatte.
- Zahnspiel-Einstellung (16Z–25Z) liegt im Motorhalter; das Lochbild Motorhalter ↔ Grundplatte ist fest.
- Gewindeeinsätze MP-JET M3 kurz (Stückliste Pos. 30), Bohrung vorläufig Ø 4,0 × 6 mm, bei Lieferung messen.
- Grundplatte flach, ohne Kick-up; Unterfahrschutz kommt mit „Karosseriehalter und Rammschutz“.
- Steifigkeitssimulation ist nur Abschätzung; verbindlich ist die Messung am Prototyp.

## Nicht Teil dieser Anforderung
- Konstruktion von Getriebegehäusen, Motorhalter, Zahnradabdeckung, Servohalter, Querlenkerböcken, Lenkhebelsystem, Dämpferbrücken (nur deren Lochbilder bzw. Fußflächen und die Oberdeck-Auflagen)
- Akkubügel und Pfosten, Adapterplatten für Regler, Empfänger und UBEC, Kabelführung („Elektronikhalter“)
- Karosseriehalter und Rammschutz selbst (nur Lochbilder)
- Aufhängungs- und Lenkgeometrie (Querlenkerlängen, Sturz, Ackermann)
- Änderungen an den Maßen des Skeletts
- CAM-Programme für die echte Alu-Fertigung (Phase 3)
- Drucken und Probemontage selbst (macht der Nutzer)

## Offene Punkte
- keine, die die Umsetzung blockieren

## Nachweis
Umgesetzt am 2026-10-31 im Fusion-Design „open-rc-car-grundplatte“, Review 1 eingearbeitet am 2026-10-31 (Version 10), Fügespiel am Stoß nach Nutzerentscheidung eingearbeitet am 2026-10-31 (Version 11), Änderung 2026-11-13 (Überstand 20 mm, Lochreihe Rammschutz/Karosseriehalter verlegt) eingearbeitet am 2026-11-13: **Version 12** (f3d, beide STEP und STL der geänderten Teile aus Version 12, übrige unverändert), abgeleitet von „open-rc-car-skelett“ **v12** (nach dem Parametertest, maßgleich mit v10; Nutzerentscheidung 2026-10-31). Einzelheiten, Messwerte und Bilder: `docs/grundplatte-oberdeck.md`. Der Nachweis der Fassung 1 steht in der Git-Historie (Commit `0a0ae17`).

| ID | Status | Nachweis |
|---|---|---|
| MECH-CHA-001 | ✅ erfüllt | Neue Versionen (v8 Zwischenstand, v9, v10 nach Review 1, v11 mit Fügespiel, v12 Überstand 20 mm) desselben Designs. Alte Ableitung (Skelett v6) und alle Features und Parameter der Fassung 1 entfernt; Ableitung neu angelegt: 155 Parameter (`*_Ref`), 8 Bezugsebenen, 38 Hüllkörper-Komponenten. Referenz nach dem Parametertest auf Skelett v12 (maßgleich v10); der Name des Zeitleisten-Elements bleibt „Abgeleitet von open-rc-car-skelett v10“ (über die API nicht änderbar). 98 neue Benutzerparameter (seit v11 mit `stoss_spiel`, seit v12 mit `gp_db_x`, `gp_ende_db_abstand`, `gp_ende_loch_reserve`) mit Präfix `gp_`, `od_`, `ms_`, `raster_`, `akku_`, `stoss_`, `ql_`, `lk_`, alle mit Kommentar. 27 Skizzen, alle voll bestimmt. **Test `stoss_spiel`** (v11): 0,3 mm → Zeitleiste (85) ohne Fehler, Druckteile X −172…14,7 / −14,7…172, Alu unverändert; zurück auf 0,2 mm → X …14,8 / −14,8…, ohne Fehler. **Parametertest mit dem Skelett:** `radstand` 280 mm (Skelett v11) → Ableitung aktualisiert → Zeitleiste (83) ohne Fehler, Platte 358 × 144 mm, Oberdeck, Fußflächen und Lochbilder folgen, Interferenz 0, Bock hinten vor der Achse ↔ Wellenraum 7,39 / Zahnradabdeckung 1,00 / Dämpfer 1,79 mm (Screenshot `docs/images/grundplatte-parametertest-280.png`). Dabei gefunden und behoben: feste Rasterspaltenzahl ließ bei 280 mm eine Bohrung ins Leere gehen → `raster_nx` aus dem Umriss abgeleitet, danach Randabstand ≥ 5,00 mm. Zurück auf 266 mm (Skelett v12): wieder 107 Bohrungen, 344 × 144 mm, Zeitleiste ohne Fehler. **v12:** Ersatztest `gp_ueberstand` 25 mm + `akku_einsatz_d` 4,6 mm → Lochreihe 172,0, Platte 364 mm, Zeitleiste (85) ohne Fehler, zurückgesetzt; Skelett-Test nicht wiederholt (keine neuen Skelett-Bezüge außer `achse_x` in `gp_db_x`). Einzelheiten in `docs/grundplatte-oberdeck.md`, Abschnitt „Parametertest“. |
| MECH-CHA-002 | ✅ erfüllt | Version 12: Hüllquader gemessen **354,00 × 144,00 × 4,00 mm** (314 + 2 × `gp_ueberstand` **20 mm**), Unterkante Z 25,00. Akkuschacht links bis Y 70, Fußflächen der Querlenkerböcke in den Plattenenden (±46). Interferenz gegen alle Bewegungsräume: 0; Mindestabstand Radräume **8,55 mm** (≥ 5; Radräume vorne mit Lenkeinschlag ±30°), Wellenräume **11,15 mm** (≥ 3). Zusätzlich die Verlängerung (X ±172…±177) gegen die echten Achsen: Vorderachse v8 in 9 Stellungen (Federweg × Lenkung voll links/geradeaus/voll rechts) Räder ≥ **26,13 mm**, Dämpfer 4,60, Querlenker 6,05 mm; Hinterachse v14 in 3 Stellungen Räder ≥ **33,90 mm**, Dämpfer 10,12 mm; 0 Überschneidungen. |
| MECH-CHA-003 | ✅ erfüllt | Druckteile je **191,8 × 144,0 mm** (≤ 250 × 250, Version 12). **Fügespiel** `stoss_spiel` = 0,2 mm an den senkrechten Stufenflächen (Zungenenden um 0,2 mm zurückgesetzt, Features „stoss-spiel-hinten/-vorne“ = Fläche versetzen um `-stoss_spiel`): gemessen Zunge hinten (X 14,80) ↔ Stufe vorne (X 15,00) **0,200 mm**, Zunge vorne (X −14,80) ↔ Stufe hinten (X −15,00) **0,200 mm**; waagerechte Anlage Z 27 ohne Spiel (Abstand 0,000), Interferenz hinten ↔ vorne 0. Schrauben durch beide Lagen: Mittelstütze 4 + Akkuanschlag links 1 + rechts 1 = **6** (alle M3 × 8 Senkkopf von unten in Gewindeeinsätze), dazu 9 Rasterbohrungen. Unterseite im Stoß flach (Senkungen in der unteren Lage). Keine Muttern; Schraubenenden im Sackloch der Einsätze (Z 33 < 35), Interferenz Anschläge und Mittelstütze ↔ Skelett: 0. |
| MECH-CHA-004 | ✅ erfüllt | Körper `grundplatte-alu` einteilig aus derselben Kontur und denselben Features; das Fügespiel wirkt nur auf die Druckkörper (Alu-Volumen bei 0,2 und 0,3 mm unverändert 152,577 cm³, seit v12 156,257 cm³). Prüfskript (v11, Lochpositionen in v12 erneut ausgelesen): 107 Lochpositionen Alu = 107 Druck (vereint), identisch; reine Stoßbohrungen gibt es nicht. `cad/step/chassis-grundplatte-alu.step` mit genau 1 Körper (grep `MANIFOLD_SOLID_BREP`). |
| MECH-CHA-005 | ✅ Prüfskript 2,5D/Radien und Kontur-Operation; ⏳ Phase 3: Bohr-NC, Senken, Taschen-Operation, Simulation (Entscheidungen 2026-10-28) | Prüfskript (Alu, Druckteile, Oberdeck): nur Ebenen parallel/senkrecht zur Plattenebene, senkrechte Zylinder, Kegel nur an den Senkungen (45°, unten). Radien 2,0 (Umriss, Taschen), 3,0/5,0 (Oberdeck), alle ≥ 1,5. Keine Hinterschnitte. CAM-Setup „grundplatte-alu von unten“ auf den neuen Körper umgestellt, 2D-Kontur mit Fräser Ø 3 mm ohne Fehler und Warnung berechnet (v12: Modell und Konturauswahl neu zugewiesen, erneut ohne Fehler und Warnung). Die alte Bohroperation (1 von 105 Bohrungen im Post) ist entfernt. |
| MECH-CHA-006 | ✅ erfüllt | Gemessen: Grundplatte 4,00 mm (`plattenstaerke`), Oberdeck 3,00 mm (`od_staerke`). Keine Rippen, keine Druck-Sondergeometrie außer dem Stoß. |
| MECH-CHA-007 | ✅ erfüllt | Schnittstellenblatt in `docs/grundplatte-oberdeck.md` mit Anzahl, Koordinaten und Parametern: Hinterachsgetriebe 4, Vorderachsgetriebe 4, Motorhalter 3 (Motor hinten rechts), Servohalter 4, Querlenkerböcke 8 × 2, Lenkhebel 2 × 2, Mittelstütze 4, Akkuanschläge 3 + 3 + 2 + 2, Bügelpfosten hinten 2 (vorne = Anschlag vorne), Rammschutz und Karosseriehalter vorne/hinten je 2, Raster 48; Summe 107. Screenshot von unten `docs/images/grundplatte-unten.png` (v12). **Änderung 2026-11-13:** Lochreihe Rammschutz/Karosseriehalter bei X **±169,35** (`gp_ende_loch_x`, mittig zwischen Brücke + 4,2 mm und Plattenende − 5 mm, Reserve 2,65 mm zu beiden Grenzen), Y ±8 / ±22. Gemessen in Fusion (Lochachse ↔ Dämpferbrücke in „open-rc-car-vorderachse“ v8 und „open-rc-car-hinterachse“ v14): **6,85 mm** an allen 8 Löchern (≥ 4,2); Randabstand zum Plattenende **7,65 mm** (≥ 5). |
| MECH-CHA-008 | ✅ erfüllt (mit Ausnahme an den Stoßstufen, Nutzerentscheidung 2026-10-31) | Prüfskript (v11): alle 107 Bohrungen Ø 3,2 mm mit 90°-Senkung Ø 6,9 mm unten (Kegel 45°, Z 25,00…26,85). Randabstand Lochmitte ↔ Kanten der Ober- und Unterseite, analytisch über die Kanten (v12: Lochreihe Rammschutz/Karosseriehalter ↔ Plattenende 7,65 mm, Lochabstand min. weiter 8,56 mm): an den Stoßstufen der Druckteile min. **4,80 mm** (Löcher X ±10 ↔ Zungenenden X ±14,8; Soll ≥ 4,8), sonst überall min. **5,00 mm** (Umriss, Taschen, Stufen X ±15 zu den Löchern X ±20); Alu min. **5,00 mm**. Wand Senkung ↔ Stufe min. **1,35 mm** (Senkungen X 10 im hinteren Teil ↔ Zungenende X 14,8; Soll ≥ 1,2), sonst ≥ 1,55 mm. Lochabstand min. **8,56 mm**. Unterseite ohne vorstehende Teile. |
| MECH-CHA-009 | ✅ erfüllt | Raster 10 mm, X −70…80, Y −69/−59/−49 (48 Bohrungen), Takt an `teilung_x`, Spaltenzahl `raster_nx` aus dem Umriss abgeleitet; Spalten −10/0/10 im Stoß durch beide Teile. Unter den Hüllkörpern: Empfänger 15, Regler 18, UBEC 15 (je ≥ 4; bei `radstand` 280 mm 12/15/15). Kein Rasterloch unter Motor (Y bis −46,5), Motorhalter- oder Servohalter-Lochbild (min. 8,56 bzw. 12,8 mm). |
| MECH-CHA-010 | ✅ erfüllt | Vier verschraubte Anschläge, Spiel zum Akku je Seite **1,00 mm** gemessen; Interferenz mit Akku, XT60 und allen Skelett-Körpern 0. Vorderer Anschlag links neben dem XT60 (2,50 mm), nicht davor; er ist Platzhalter für den vorderen Bügelpfosten (gleiches Lochbild). Lochbild Pfosten hinten (−84 / 30,5; 39,5). Entnahmeweg frei (Anschläge 15,19 mm, Oberdeck 2,00 mm). Kanten zum Akku R 1,5 mm, keine Schraubenenden zum Akku. |
| MECH-CHA-011 | ✅ erfüllt | Oberdeck 244,0 × 41,0 × 3,0 mm (≤ 250 × 250), einteilig, je 2 × M3 auf Hinterachsgetriebe (−115 / ±5), Mittelstütze (0 / −16; −26) und Vorderachsgetriebe (115 / ±5). Interferenz gegen alle 38 Skelett-Körper: 0, Mindestabstand **1,00 mm** (Zahnradabdeckung). Auflagehöhe **Z 84,2 mm** im Schnittstellenblatt (Vorgabe Getriebegehäuse +3,6 mm über die Hülle). |
| MECH-CHA-012 | ✅ erfüllt | Interferenz Grundplatte/Oberdeck ↔ `mittelantrieb-zahnradabdeckung`: 0 (Abstände 1,00 / 1,00 mm). Befestigungspunkt: Lochbild Motorhalter (3 × M3), im Schnittstellenblatt benannt. |
| MECH-CHA-013 | ✅ erfüllt, 🔧 Slicer | Druckausrichtung und Wandstärken in `docs/grundplatte-oberdeck.md`: alle Teile flach ohne Stützen (vordere Platte kopfüber, Mittelstütze auf der Seitenfläche). Wände/Stege min. 1,35 mm (Senkung ↔ Zungenende am Stoß, mit Fügespiel), sonst 1,55 mm (Senkung ↔ Rand/Stufe), 1,66 mm (Senkung ↔ Senkung), Taschenränder 3,0 mm. Bohrungen 3,2 mm, Fügespiel am Stoß 0,2 mm. STL-Hüllquader: größtes Teil 244 × 41 × 3 mm, Plattenhälften 191,8 × 144 × 4 mm (≤ 256 × 256, v12). Kein Slicer installiert, Slicer-Prüfung durch den Nutzer. |
| MECH-CHA-014 | ✅ erfüllt | Design gespeichert (Version 12), alle Exporte aus Version 12: `cad/fusion/chassis-grundplatte-oberdeck.f3d`, `cad/step/chassis-grundplatte-oberdeck.step` (8 Körper: Grundplatte hinten/vorne, Oberdeck, Mittelstütze, 4 Anschläge), `cad/step/chassis-grundplatte-alu.step` (1 Körper), 8 STL `print/stl/chassis-grundplatte-hinten/-vorne`, `chassis-oberdeck`, `chassis-mittelstuetze`, `chassis-akkuanschlag-links/-rechts/-vorne/-hinten` (LFS; STL-Hüllquader nachgeprüft). Skelett als v11/v12 nur für den Parametertest gespeichert, Geometrie v12 = v10, Skelett-Exporte deshalb unverändert. Stückliste: Pos. 41, 42 aktualisiert, Pos. 54 Mittelstütze, 55 Akkuanschläge, 56 Aluvariante neu, Pos. 47 Mittelschott als entfallen markiert, Schrauben und Einsätze (Pos. 17, 24, 30) mit Verwendung ergänzt (in Review 1 keine neuen Teile; mit dem Fügespiel Pos. 41 Masse und Maße nachgezogen; mit v12 Pos. 41 und 56 Maße und Masse nachgezogen). |
| MECH-CHA-015 | 🔧 am Prototyp prüfen | Probemontage durch den Nutzer, Prüfliste in `docs/grundplatte-oberdeck.md`, Abschnitt „Probemontage“ (Zungen fügen mit 0,2 mm Spiel ohne Kraft, Stoßbohrungen fluchten, Versatz ≤ 0,3 mm, Stoß ohne Adapterplatten klafft nicht, Einsätze der Mittelstütze gerade und fest). |
| MECH-CHA-016 | 🔧 am Prototyp prüfen | Durchbiegung unter 20 N messen. Fusion-Simulation über die API nicht möglich. Handabschätzung in `docs/grundplatte-oberdeck.md`: ohne Kopplung von Platte und Oberdeck ≈ 4,8 mm (> 2 mm), bei starrer Kopplung ≈ 0,02 mm; das Ergebnis hängt an der Rahmenwirkung über Getriebegehäuse und Mittelstütze, deshalb gezielt messen. |
| MECH-CHA-017 | ✅ erfüllt (Soll seit 2026-11-13 ≤ 255 g) | Masse aus Fusion (Volumen × 1,27 g/cm³, PETG, 100 %), Stand v12: Grundplatte 99,4 + 98,9 g, Oberdeck 20,7 g, Mittelstütze 17,6 g, Anschläge 15,0 g, **gesamt 251,6 g** (Soll ≤ 255 g; das alte Soll 250 g wäre um 1,6 g überschritten). Ursache: die vom Nutzer beschlossene Verlängerung um 2 × 5 mm (+4,7 g); v11 hatte 247,0 g. In Prusament PC 237,8 g. Weiterhin nur mit den Erleichterungstaschen aus MECH-CHA-019 so leicht (ohne ca. 258 g). |
| MECH-CHA-018 | ✅ erfüllt (Lochbilder), Vorgabe an Achsen | Alle Schrauben von Querlenkerböcken, Lenkhebel-Lagerböcken, Servo- und Motorhalter kommen von unten (Senkkopf). Keine Bock-Fußfläche liegt unter einer Getriebe-Hülle (Fußflächen ab Y ±27, Getriebe bis ±24,86; Diff-Becher X ±122,7…±143,3 liegen zwischen den Böcken) oder unter dem Oberdeck (Y −31…10). Vorgabe an die Achsen: Gehäuse bis Z 44 innerhalb Y ±24,86. |
| MECH-CHA-019 | ✅ umgesetzt (KANN), **nötig für MECH-CHA-017** | Vier Erleichterungstaschen zwischen den Querlenkerböcken (X ±123…±143, Y ±27…±43), R 2 mm, 6,4 g leichter. |
| MECH-CHA-020 | ✅ erfüllt | Je Achse 4 Fußflächen neben dem Getriebe, vor und hinter der Achse (X ∓156…∓146 / ∓120…∓110 bzw. 110…120 / 146…156, Y ±27…±43, Z 29…44), je 2 × M3; Koordinaten im Schnittstellenblatt. Interferenz ↔ Skelett: 0; Wellenraum ≥ 6,94 mm (≥ 3), Radraum ≥ 31,95 mm (≥ 5), Zahnradabdeckung 1,00 mm, Dämpfer 1,79 mm; bei `radstand` 280 mm unverändert (Parametertest). Vorgabe an „Mittelantrieb“: Zahnradabdeckung im Bereich der Fußfläche hinten rechts nicht hinter X −109. |
| MECH-CHA-021 | ✅ erfüllt | Mittelstütze rechts neben der Kardanwelle am Stoß (X −15…15, Y −31…−11, Z 29…84,2), unten 4 × M3 durch beide Lagen, oben 2 × M3 zum Oberdeck, Gewindeeinsätze in der Stütze. Interferenz ↔ Skelett: 0; Regler **1,00 mm**, Kardanwelle 4,00 mm, Motor 8,16 mm, Entnahmeweg > 21 mm. Hüllquader 30 × 20 × 55,2 mm, Druck auf der Seitenfläche liegend ohne Stützen (dokumentiert). |
| MECH-CHA-022 | ✅ erfüllt | Zwei Lagerböcke: links (94,5 / 30,5; 39,5), Fußfläche X 90,5…98,5 (`lk_x`, am XT60), rechts (92,75 / −46,5; −55,5), Fußfläche X 88,75…96,75 (`lk_x_rechts`, 2 mm vor der Dämpfer-Hülle, Review 1), zwischen Servo/XT60 und Vorderachsgetriebe; Begründung im Schnittstellenblatt (kurze Anlenkung vom Servo-Saver wie beim TT-02B). Interferenz: 0; Abstände links XT60 1,00 / Getriebe 2,20 mm, rechts Dämpfer **2,00** / UBEC 6,25 / Servo 10,8 mm; Radraum ≥ 12,46 mm, Wellenraum ≥ 27,55 mm (mit Lenkeinschlag). |
| DOC-CHA-001 | ✅ erfüllt | `docs/grundplatte-oberdeck.md` neu: Schnittstellenblatt, Parameterliste, Stoß, Oberdeck-Auflagehöhe, Mittelstütze, Vorgaben an Hinterachse, Vorderachse/Lenkung, Mittelantrieb, Elektronikhalter, Druckhinweise, Screenshots oben/unten/iso (`docs/images/grundplatte-*.png`, mit v12 erneuert, ebenso `grundplatte-skelett-iso.png`, dazu Parametertest und Detail Fügespiel `grundplatte-stoss-spiel.png`), Abschnitt Probemontage. Verweise auf den früheren Spender nur im Abschnitt „Historie“. |
| DOC-CHA-002 | ✅ erfüllt | `docs/plan.md`: Entscheidungen dieser Fassung eingetragen (Änderung 2026-11-13 als eigener Eintrag), offener Punkt abgehakt, Phase 1 Punkt 1 als umgesetzt markiert (Probemontage offen), Phase-3-Punkt zu Bohr-NC, Senken und Simulation ergänzt. |

**Abweichungen und offene Punkte aus der Umsetzung:**
- **Masse (MECH-CHA-017, SOLL, Änderung 2026-11-13):** 251,6 g, über dem alten Soll von 250 g, weil die Plattenenden je 5 mm länger sind. Nutzerentscheidung 2026-11-13: Soll auf ≤ 255 g angehoben (100 % Füllung ist die obere Grenze). Verworfen: Verlängerung schmaler (weniger Auflage für den Träger), weitere Taschen unter den Getrieben.
- **Lochreihe Rammschutz/Karosseriehalter hängt an Kopien:** `gp_db_x` kopiert die Lage der Dämpferbrücken (Vorderachse, Hinterachse). Ändert sich eine Brücke, `gp_db_x` von Hand nachziehen; das Prüfmaß `gp_ende_loch_reserve` muss ≥ 0 bleiben.
- **Fügespiel am Stoß (Review 1, Befund 2, erledigt nach Nutzerentscheidung 2026-10-31):** `stoss_spiel` = 0,2 mm an den senkrechten Stufenflächen der Druckteile (Zungenenden zurückgesetzt), waagerechte Anlage ohne Spiel, Aluvariante unverändert. Randabstand an den Stufen dadurch 4,80 mm statt 5,00 mm (Ausnahme in MECH-CHA-008), Wand Senkung ↔ Stufe 1,35 mm. Raster bleibt durchgehend. Ob die Zungen ohne Kraft fügen und der Versatz ≤ 0,3 mm bleibt, zeigt die Probemontage (MECH-CHA-015).
- Stoß ohne eigene Stoßschrauben und Muttern: Die 6 Schrauben durch beide Lagen sind die der Mittelstütze und der mittleren Löcher der Anschläge links/rechts (Konstruktionsentscheidung, erlaubt durch MECH-CHA-003). Die Anschläge links/rechts sind damit tragend für den Stoß und immer zu montieren; die 9 Rasterbohrungen im Stoß klemmen erst mit den Adapterplatten.
- Lagerböcke Lenkhebel neben dem Servo statt auf der Verlängerung vorne (eine der beiden in MECH-CHA-022 genannten Lagen); seit Review 1 mit getrennter Lage links/rechts.
- Oberdeck 20 mm breit (Fassung 1: 30 mm), weil der Akku-Entnahmeweg links ab Y 12 beginnt; Steifigkeit am Prototyp messen (MECH-CHA-016).
- Elektronik-Raster mit 3 statt 4 Reihen (Motor, Servohalter); je Gerät trotzdem ≥ 15 Löcher. Adapterplatten können nur die Reihen Y −69…−49 nutzen (Vorgabe an „Elektronikhalter“).
- Masse 251,6 g (v12) nur mit den Erleichterungstaschen (KANN) unter dem Soll ≤ 255 g, ohne Taschen ca. 258 g; die Taschen bleiben nötig.
- Gewindeeinsätze MP-JET M3 kurz: Bohrung Ø 4,0 × 6 mm vorläufig, bei Lieferung messen. Die 6 Einsatzbohrungen der Mittelstütze werden waagerecht gedruckt und überbrückt (keine Tropfenform); Prüfpunkt in der Probemontage.
