ZaphodBytebrox/open-rc-car/docs/anforderungen/vorderachse.md

# Anforderungen: Vorderachse und Lenkung

- **Kürzel:** VAC
- **Domäne:** Mechanik
- **Status:** umgesetzt (Nachweis unten; MECH-VAC-001, -007, -011 teilweise und MECH-VAC-021 nicht erfüllt, Entscheidung des Nutzers offen)
- **Stand:** 2026-11-08

## Zweck
Die gelenkte, in v1 nicht angetriebene Vorderachse des 2WD-Prototyps: Frontschott (Platzhalter für das spätere Vorderachsgetriebe), Querlenkerböcke und untere Querlenker, C-Hubs und Achsschenkel für die Bausatz-Radachsen, Dämpferbrücke vorne, Lenkhebelsystem mit zwei Umlenkhebeln, gedrucktem Servo-Saver und Spurstangen sowie der Servohalter. Die Aufhängung folgt dem TT-02B und der Bauweise der Hinterachse. Alle Teile sitzen auf den Lochbildern und Fußflächen, die Grundplatte und Oberdeck (Fassung 2) festgelegt haben.

**Meilenstein:** Vorderachse und Lenkung sind konstruiert, in Fusion über Federweg und vollen Lenkeinschlag kollisionsfrei und als Druckteile exportiert. Nach Lieferung des Bausatzes werden die vorläufigen Maße gemessen und die Teile ggf. neu gedruckt.

## Schnittstellen
| Zu | Art | Beschreibung |
|---|---|---|
| Skelett (`skelett.md`, Design „open-rc-car-skelett“, aktuelle Version) | mechanisch | Parameter und Hüllkörper per Ableiten: `achse_x` 133, `spurbreite_v` 217 (`rad_y_v` 108,5), `rad_durchmesser` 82, `rad_breite_v` 32, `federweg` 35 (vorläufig, 2/3 ein, 1/3 aus), `lenkwinkel_max` 30°, `lenkachse_versatz` 20 (Lenkachse Y ±88,5), Radachsen vorne, Wellenräume vorne mit Lenkeinschlag (4WD), Dämpfer-Hüllen vorne (`daempfer_l_v`), Servo (X 57,2…97,5, `servo_y` −22,1), Vorderachsgetriebe-Hülle, XT60, UBEC |
| Grundplatte und Oberdeck (`grundplatte-oberdeck.md`, Design „open-rc-car-grundplatte“, aktuelle Version) | mechanisch | Vorderachsgetriebe-Lochbild 4 × M3 an (114 / ±18) und (152 / ±18) → trägt in v1 das Frontschott. Oberdeck-Auflage bis **Z 84,2** an (115 / ±5). Querlenkerböcke auf X 110…120 und 146…156, Y ±27…±43, je 2 × M3 (Y ±30,5 / ±39,5). Servohalter 4 × M3 an (53,2 / −27,1; −17,1) und (85,0; 95,0 / −37,2). Lagerböcke Lenkhebel links (94,5 / 30,5; 39,5), Fußfläche X 90,5…98,5; rechts (92,75 / −46,5; −55,5), Fußfläche X 88,75…96,75, **nicht über X 97,75 hinaus**. Alle Schrauben M3-Senkkopf von unten, Gewinde im aufgesetzten Teil. |
| Hinterachse (`hinterachse.md`) | Vorbild | Gleiche Bauart und Parameterregeln: Böcke, Querlenkerstift Ø 3 mm, Kugelköpfe 5 mm (Pos. 62), Lager- und Bohrungstoleranzen, Material |
| Bausatz TT-02B 58568 | mechanisch | Radachsen vorne mit 12-mm-Mitnehmer (Pos. 8), 4 Lager 5x11x4 (Pos. 14), CVA-Dämpfer vorne (Pos. 9), Räder vorne 32 × 82 mm, Kugelköpfe/-pfannen (Pos. 11); für 4WD später Vorderdiff und vordere Antriebswellen |
| Zukauf | mechanisch | Spannschloss-Satz Tamiya 54539 (Pos. 61: 2 × obere Lenker vorne, 2 × Spurstangen, 1 × Lenkgestänge), Lager 5x8x2,5 (Pos. 15, 4 Stk), Lenkservo Savöx SC-1258TG+ (Pos. 34, 25Z, 12 kg·cm bei 6 V), Feder für den Servo-Saver (neu) |
| Empfänger/Servo | Signal | Kanal 1 Lenkung, Failsafe 1500 µs = Servomitte |

## Anforderungen
| ID | Priorität | Anforderung | Abnahmekriterium |
|---|---|---|---|
| MECH-VAC-001 | MUSS | Eigenes Fusion-Design „open-rc-car-vorderachse“ im Projekt „open-rc-car“, abgeleitet vom Skelett und von der Grundplatte (Lochbilder, Fußflächen, Oberdeck). Neue Maße sind Benutzerparameter mit Präfix `va_` und Kommentar (Quelle, „belegt“ oder „vorläufig“). Alle kritischen Bausatz- und Zukaufmaße (Lagersitze, Radachse, Dämpferaugen, Kugelkopfmaße, Servo-Laschen und Abtriebshöhe, Federmaße Servo-Saver) sind eigene Parameter. | Parameterliste in Fusion, jede mit Kommentar; Skizzen voll bestimmt. Test: `radstand` im Skelett auf 280 mm → Ableitung aktualisiert ohne Fehler, Teile folgen der Vorderachse, danach zurück auf 266 mm. |
| MECH-VAC-002 | MUSS | **Frontschott** (Nutzerentscheidung 2026-11-08) statt Vorderachsgetriebe in v1: auf dem Getriebe-Lochbild 4 × M3 (114 / ±18; 152 / ±18) mit Gewindeeinsätzen, Oberdeck-Auflagen an (115 / ±5) genau bis Z 84,2 mm mit je einem Gewindeeinsatz, trägt die Dämpferbrücke vorne. Das Schott bleibt innerhalb der Hülle des Vorderachsgetriebes und bis Z 44 innerhalb Y ±24,86 (Fußflächen der Böcke frei), damit es für 4WD ohne Änderung an Grundplatte, Oberdeck und Böcken durch das Getriebe ersetzt werden kann. Die Wellenräume vorne bleiben frei. | Interferenz Schott ↔ Grundplatte, Fußflächen, Oberdeck, Wellenräume: 0 (Berührung an Auflageflächen gewollt). Lochmitten gemessen, Auflagehöhe 84,20 mm. Schott liegt vollständig in der Getriebehülle (Interferenz Schott minus Hülle = 0). |
| MECH-VAC-003 | MUSS | **Aufhängung wie TT-02B** (Nutzerentscheidung 2026-11-08): je Seite ein gedruckter **unterer Querlenker** auf zwei Querlenkerböcken (vor und hinter der Achse, Stützweite 36 mm, Anlenkachse parallel zu X, Stahlstift Ø 3 mm), außen ein **C-Hub** (Achsschenkelträger) mit festem Nachlauf, darin der **Achsschenkel** drehbar auf zwei Kingpin-Schrauben M3 (oben und unten). Oben je eine **einstellbare Sturzstange** aus 54539 zwischen C-Hub und Dämpferbrücke bzw. Schott. | Modell: 2 Querlenker, 4 Böcke, 2 C-Hubs, 2 Achsschenkel, 2 Sturzstangen vorhanden; Böcke auf den Fußflächen der Grundplatte. |
| MECH-VAC-004 | MUSS | **Querlenkerböcke vorne** (Druckteile): je 2 × M3 von unten (Gewindeeinsätze im Bock), Fußfläche innerhalb X 110…120 bzw. 146…156, Y ±27…±43. Über Z 44 darf ein Bock wachsen, wenn er nicht mit Wellenräumen, Dämpfern, Schott oder Lenkung kollidiert. Jeder Bock ist von unten lösbar, ohne Schott, Dämpferbrücke oder Oberdeck abzunehmen. | Interferenz Böcke ↔ Skelett, Schott, Lenkung: 0, Mindestabstand ≥ 1 mm (zu Wellenräumen ≥ 3 mm). Sichtprüfung: Schrauben von unten erreichbar. |
| MECH-VAC-005 | MUSS | **Achsschenkel** (Druckteil, links/rechts): lagert die Radachse vorne (Pos. 8) in 2 Lagern 5x11x4, Lagerabstand als Parameter; sichert die Radachse in v1 axial (keine Antriebswelle). **4WD-tauglich:** Für die spätere vordere Antriebswelle bleibt der Durchgang innen frei (Becher der Radachse, Wellenraum mit Lenkeinschlag). Radmitte in Konstruktionslage bei Y = ±`rad_y_v` (108,5), Z = `rad_durchmesser`/2. Lenkachse im Abstand `lenkachse_versatz` innerhalb der Radmitte. Spurhebel am Achsschenkel mit Kugelkopf 5 mm für die Spurstange. | Messen: Radmitte Y ±108,5 / Z 41,0; `radachse_v_spiel` 0 ± 0,5 mm; Lenkachse Y ±88,5 ± 0,5 in Radmittenhöhe. Interferenz Achsschenkel ↔ Rad, Radachse, Wellenraum vorne: nur gewollte Berührungen. Axialsicherung der Radachse im Schnittbild gezeigt. |
| MECH-VAC-006 | MUSS | **Lenkgeometrie:** Nachlauf fest im C-Hub (`va_nachlauf`, vorläufig 4°), Spreizung `va_spreizung` (vorläufig 0°), Sturz statisch `va_sturz` (vorläufig −1°) über die Sturzstange mindestens −3° bis 0° einstellbar, Vorspur statisch 0° über die Spurstangen mindestens −2° bis +2° einstellbar. | Werte in Konstruktionslage gemessen; Einstellbereiche aus den Gewindelängen der Spannschlösser gerechnet und in `docs/vorderachse.md` belegt. |
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
