ZaphodBytebrox/open-rc-car/bom/stueckliste.csv

Pos | Baugruppe | Bezeichnung | Menge | Einheit | Typ | Hersteller | Teilenummer | Material/Spezifikation | Datei/Bezugsquelle | Shop | Link | Preis_EUR | Summe_EUR | Verfügbarkeit | Masse_Konstruktion | Quelle_Masse | Bemerkung
1 | Spenderplattform | Bausatz Tamiya Neo Scorcher TT-02B 1:10 4WD (Teilespender) | 1 | Stk | Zukauf | Tamiya | 58568 | TT-02B, Kardanantrieb 4WD, Kegelrad-Diffs vorne/hinten (Harz), 4 Öldämpfer, Spike-Reifen, Motor 540, Regler; Gleitlager (Kunststoffbuchsen) | TAMICO (tamico.de) | TAMICO (tamico.de) | https://tamico.de/Tamiya-Neo-Scorcher-TT-02B-Kit-58568 | 110.91 | 110.91 | auf Lager, 1-3 Werktage (28.10.2026) | Radstand 266 mm, Spur 217 mm vorne / 208 mm hinten, Reifen 32/82 mm vorne und 41/82 mm hinten, Übersetzung 10,71 : 1 mit Bausatzritzel | Tamiya-Produktseite 58568 (Specifications); Lieferumfang Shopseite TAMICO | Preis laut Shopseite inkl. 20 % MwSt. angezeigt, DE-Preis kann leicht abweichen. Nicht verbaut und Reserve: Wanne, Querlenker, Motor 540, Regler. Nutzerentscheidung 2026-10-28: Bausatz statt Einzelteile; genutzt: Karosserie Neo Scorcher mit Karosserieklammern (Pos. 87, 88, Karosseriehalter, docs/karosseriehalter-rammschutz.md)
2 | Antrieb hinten | Hinterachsdifferential mit 4 Kegelrädern, Tellerrad und Kegelritzel (Harz) | 1 | Stk | Bausatz | Tamiya | Nr. laut Anleitung 58568 | 4-Kegelrad-Diff, Getriebe abgedichtet; Diff-Übersetzung rechnerisch 2,6 : 1 | aus Pos. 1 (Bausatz 58568) |  |  |  |  | - | Lagersitze, Achsabstand Tellerrad zu Kegelritzel und Wellendurchmesser am Teil messen | Tamiya-Produktseite 58568; Übersetzung aus 10,71 : 1 mit 17Z/70Z gerechnet (docs/zukaufteile-v1.md) | Gehäuse ist beim TT-02B Teil der Wanne → Getriebegehäuse ist Eigenbau (Pos. Getriebe- und Differentialgehäuse)
3 | Mittelantrieb | Kardanwelle (Propeller Shaft) mit Gelenken | 1 | Stk | Bausatz | Tamiya | Nr. laut Anleitung 58568 | Kunststoff | aus Pos. 1 (Bausatz 58568) |  |  |  |  | - | Länge und Kupplungen am Teil messen | - | Legt den Abstand zwischen Mittelantrieb und Hinterachsgetriebe fest; v1 nur nach hinten belegt; Mittelantrieb v1: NICHT EINGEBAUT (Nutzerentscheidung 2026-11-01), überträgt bei 2WD nichts; Reserve für 4WD, Becheröffnung E2 mit Blinddeckel (Pos. 66) verschlossen
4 | Mittelantrieb | Hauptzahnrad 70Z Modul 0,6 | 1 | Stk | Bausatz | Tamiya | Nr. laut Anleitung 58568 | Kunststoff, Modul 0,6 | aus Pos. 1 (Bausatz 58568) |  |  |  |  | - | 70 Zähne (rechnerisch), Bohrung und Mitnahme am Teil messen | Rechnung: 10,71 : 1 ÷ 2,6 × 17 = 70,0 (docs/zukaufteile-v1.md) | Wird in die eigene Rutschkupplung eingebaut (Nutzerentscheidung 2026-10-28); Zähnezahl beim Auspacken prüfen
5 | Mittelantrieb | Motorritzel 17Z Modul 0,6 | 1 | Stk | Bausatz | Tamiya | Nr. laut Anleitung 58568 | Modul 0,6, Bohrung für 3,175-mm-Welle (Motor 540) | aus Pos. 1 (Bausatz 58568) |  |  |  |  | - | 17 Zähne laut Übersetzung; Bohrung am Teil messen | Tamiya-Produktseite 58568 | Reserve bzw. zum Einfahren (rechnerisch 34,7 km/h); für 50 km/h siehe Motorritzel 25Z; Mittelantrieb v1: PASST NICHT – zulässig sind 20Z–25Z (Nutzerentscheidung 2026-11-01, Spalt Motordose ↔ Becher E2); entfällt, zum Einfahren ggf. 20Z–22Z Modul 0,6 zukaufen (manuell suchen)
6 | Antrieb hinten | Antriebswellen hinten (Knochen), 2 Stk | 1 | Satz | Bausatz | Tamiya | Nr. laut Anleitung 58568 | Stahl | aus Pos. 1 (Bausatz 58568) |  |  |  |  | - | Länge und Kugel-/Stiftmaße am Teil messen | - | Legen zusammen mit Diff und Radachse die Spur 208 mm hinten fest
7 | Antrieb hinten | Radachsen hinten mit 12-mm-Sechskantmitnehmer, Mitnehmerstift und Radmutter, 2 Stk | 1 | Satz | Bausatz | Tamiya | Nr. laut Anleitung 58568 | Stahl; Mitnehmer 12 mm Sechskant | aus Pos. 1 (Bausatz 58568) |  |  |  |  | - | Achsdurchmesser 5 mm (Lagersatz 5x11), Gewinde und Länge am Teil messen | Lagersatz Carson 500904054 (5x11); Rest am Teil messen | Lager im Radträger: 5x11x4 aus dem Lagersatz
8 | Vorderachse | Radachsen vorne mit 12-mm-Sechskantmitnehmer, Mitnehmerstift und Radmutter, 2 Stk (4WD-tauglich) | 1 | Satz | Bausatz | Tamiya | Nr. laut Anleitung 58568 | Stahl; Mitnehmer 12 mm Sechskant | aus Pos. 1 (Bausatz 58568) |  |  |  |  | - | am Teil messen | - | v1 nicht angetrieben: axial sichern (Konstruktion)
9 | Fahrwerk | Öldämpfer CVA mit Federn, 4 Stk | 1 | Satz | Bausatz | Tamiya | Nr. laut Anleitung 58568 | Kunststoff, öldruckgedämpft | aus Pos. 1 (Bausatz 58568) |  |  |  |  | - | Hub, Einbaulänge und Befestigung am Teil messen | Tamiya-Produktseite 58568 (CVA-Öldämpfer vorne und hinten) | Federweg ergibt sich aus diesen Dämpfern (Abschlag akzeptiert, Nutzerentscheidung 2026-10-28)
10 | Räder | Räder mit Spike-Reifen, 2 vorne + 2 hinten | 1 | Satz | Bausatz | Tamiya | Nr. laut Anleitung 58568 | 12 mm Sechskant | aus Pos. 1 (Bausatz 58568) |  |  |  |  | - | vorne 32 × 82 mm, hinten 41 × 82 mm (Breite × Durchmesser); Einpresstiefe und Nabentiefe am Teil messen | Tamiya-Produktseite 58568 | Nutzerentscheidung 2026-10-28: Räder aus dem Bausatz statt Carson All Terrain
11 | Verbindungselemente | Kugelköpfe, Kugelpfannen und 3-teilige Lenkspurstange (Lenkung); hinten nur starre obere Lenker C2 | 1 | Satz | Bausatz | Tamiya | Nr. laut Anleitung 58568 | aus dem Bausatz | aus Pos. 1 (Bausatz 58568) |  |  |  |  | - | Kugeldurchmesser und Gewinde am Teil messen | - | Der Bausatz hat keine Sturzstangen: hinten starre obere Lenker C2 (Anleitung S. 10, Schritt 17), die 4 Kugelköpfe MB8 braucht die Lenkung. Sturzstangen und Kugelköpfe der Hinterachse sind Zukauf (Pos. 61, 62; Nutzerentscheidung 2026-11-01)
12 | Antrieb (Phase 2) | Vorderachsdifferential und vordere Antriebswellen | 1 | Satz | Bausatz | Tamiya | Nr. laut Anleitung 58568 | wie hinten | aus Pos. 1 (Bausatz 58568) |  |  |  |  | - | am Teil messen | - | für 4WD (Phase 2) aufbewahren, in v1 nicht verbaut
13 | Mittelantrieb | Motorritzel 24Z und 25Z Modul 0,6, Alu (Set) | 1 | Set | Zukauf | Tamiya | 50477 | Aluminium, Modul 0,6, Bohrung 3,17 mm | manuell suchen | manuell suchen | https://www.ebay.de/itm/396705117034 |  |  | in TAMICO, Lindinger und RC Team nicht nachweisbar (28.10.2026) | 24 und 25 Zähne, Modul 0,6, Bohrung 3,17 mm (laut Angebot) | eBay-Angebote 300050477 | MANUELL SUCHEN; Richtpreis 11,96 € (eBay.de). 25Z = 51,1 km/h, 24Z = 49,0 km/h (Leerlauf, 82-mm-Räder); Mittelantrieb v1: Startwert 25Z (Parameter ma_ritzel_zaehne), Zahnbreite/Bund/Madenschraube bei Lieferung messen (docs/mittelantrieb.md)
14 | Lager | Kugellagersatz Carson für Tamiya TT-01/TT-01E/TT-02B, 16 Stk | 1 | Satz | Zukauf | Carson | 500904054 (LI-9741877) | 12 × 5x11 mm, 4 × 8x12 mm; Dichtung laut Shop nicht angegeben | Modellbau Lindinger | Modellbau Lindinger | https://www.lindinger.at/de/Fahrzeuge-Boote/Auto-Ersatzteile-und-Tuning/CARSON-KUGELLAGERSATZ-TAMIYA-TT-01-TT-01E-TT-02B/9741877 | 28.49 | 28.49 | nur noch wenige lagernd (28.10.2026) | 12 × 5x11x4 mm, 4 × 8x12x3,5 mm (Breiten laut gleichwertigem TT-02B-Satz OZRC; am Teil messen) | Produktseite Lindinger (Inhalt); Breiten: OZRC TT02B Bearing Kit | Ersetzt die Kunststoffbuchsen des Bausatzes. Dichtung beim Auspacken prüfen; sind die Lager offen, gummigedichtete MR115-2RS und MR128-2RS nachkaufen (MECH-ZUK-008); Hinterachse (docs/hinterachse.md): 2 × 8x12x3,5 im Diff, 6 × 5x11x4 (E2 2, Radträger 4); Vorderachse: 4 × 5x11x4 in den Achsschenkeln (zusammen 10 von 12)
15 | Lager | Kugellager 5x8x2,5 gummigedichtet, 2 Stk | 2 | Pck | Zukauf | XRAY | 940508 | gummigedichtet, Öl; 4 Stk für das eigene Lenkhebelsystem | RC Team (rcteam.com) | RC Team (rcteam.com) | https://www.rcteam.com/en/products/xray-ball-bearing-5x8x2-5mm-x2-940508 | 6.00 | 12.00 | verfügbar laut Shop (26.10.2026) | 5x8x2,5 mm | XRAY Ersatzteilliste XB4 2026 (940508 RUBBER SEALED) | Menge Lenkung ist Annahme (2 Umlenkhebel); Vorderachse: 4 Stk in den Umlenkhebeln (2 Pck)
16 | Verbindungselemente | Zylinderkopfschrauben Innensechskant M3x6, 30 Stk, Edelstahl | 1 | Pck | Zukauf | Robbe Modellsport | 50991108 (LI-9796360) | Edelstahl, M3, Zylinderkopf Innensechskant | Modellbau Lindinger | Modellbau Lindinger | https://www.lindinger.at/de/Bauzubehoer-Mehr/Bauzubehoer-Kleinteile/Schrauben-Muttern-Scheiben/Schrauben-metrisch/Robbe-Modellsport-Zylinderkopfschrauben-Inne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 | 2.29 | 2.29 | lagernd (26.10.2026) | M3 x 6 mm | Produktseite Lindinger (Artikelname) | Annahme: Längen und Mengen sind ein Startsortiment; genaue Längen werden nach der Konstruktion nachgetragen
17 | Verbindungselemente | Zylinderkopfschrauben Innensechskant M3x8, 30 Stk, Edelstahl | 1 | Pck | Zukauf | Robbe Modellsport | 50991109 (LI-9796361) | Edelstahl, M3, Zylinderkopf Innensechskant | Modellbau Lindinger | Modellbau Lindinger | https://www.lindinger.at/de/Bauzubehoer-Mehr/Bauzubehoer-Kleinteile/Schrauben-Muttern-Scheiben/Schrauben-metrisch/Robbe-Modellsport-Zylinderkopfschrauben-Inne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 | 2.49 | 2.49 | lagernd (26.10.2026) | M3 x 8 mm | Produktseite Lindinger (Artikelname) | Oberdeck: 6 Stk M3 × 8 Zylinderkopf von oben in Gewindeeinsätze (Getriebegehäuse 4, Mittelstütze 2); weitere Längen nach der Konstruktion; Mittelantrieb: 5 Stk M3 × 8 Zylinderkopf (Klemmschrauben Motorplatte von vorne 3, Laschen Zahnradabdeckung oben/unten 2; Laschen seit Review 2 statt M3 × 10: 4 mm Eingriff, 2 mm Reserve zum Grund der 6 mm tiefen Einsatzbohrung); zusammen 11; Vorderachse: 6 Stk (Oberdeck auf dem Frontschott 2, Servolaschen 4); Karosseriehalter/Rammschutz: 4 Stk M3 × 8 Zylinderkopf (TPU-Puffer von oben in den Mittelsteg, mit Scheibe DIN 9021, Pos. 80); zusammen 21 von 30
18 | Verbindungselemente | Zylinderkopfschrauben Innensechskant M3x10, 30 Stk, Edelstahl | 1 | Pck | Zukauf | Robbe Modellsport | 50991110 (LI-9796362) | Edelstahl, M3, Zylinderkopf Innensechskant | Modellbau Lindinger | Modellbau Lindinger | https://www.lindinger.at/de/Bauzubehoer-Mehr/Bauzubehoer-Kleinteile/Schrauben-Muttern-Scheiben/Schrauben-metrisch/Robbe-Modellsport-Zylinderkopfschrauben-Inne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 | 2.69 | 2.69 | lagernd (26.10.2026) | M3 x 10 mm | Produktseite Lindinger (Artikelname) | Annahme: Längen und Mengen sind ein Startsortiment; genaue Längen werden nach der Konstruktion nachgetragen; Hinterachse: 4 Stk (Dämpferbrücke an das Getriebegehäuse); Mittelantrieb: keine mehr (Laschen seit Review 2 mit M3 × 8, Pos. 17); zusammen 4; Vorderachse: 4 Stk (Dämpferbrücke an das Frontschott)
19 | Verbindungselemente | Zylinderkopfschrauben Innensechskant M3x14, 30 Stk, Edelstahl | 1 | Pck | Zukauf | Robbe Modellsport | 50991111 (LI-9796363) | Edelstahl, M3, Zylinderkopf Innensechskant | Modellbau Lindinger | Modellbau Lindinger | https://www.lindinger.at/de/Bauzubehoer-Mehr/Bauzubehoer-Kleinteile/Schrauben-Muttern-Scheiben/Schrauben-metrisch/Robbe-Modellsport-Zylinderkopfschrauben-Inne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 | 2.89 | 2.89 | lagernd (26.10.2026) | M3 x 14 mm | Produktseite Lindinger (Artikelname) | Annahme: Längen und Mengen sind ein Startsortiment; genaue Längen werden nach der Konstruktion nachgetragen; Hinterachse: 5 Stk (Verschraubung Gehäusehälften vorne oben 1, Dämpfer unten 2, Lagerbock E2 2); Vorderachse: 4 Stk (Dämpfer unten 2, Achsen der Umlenkhebel 2)
20 | Verbindungselemente | Zylinderkopfschrauben Innensechskant M3x20, 30 Stk, Edelstahl | 1 | Pck | Zukauf | Robbe Modellsport | 50991112 (LI-9796364) | Edelstahl, M3, Zylinderkopf Innensechskant | Modellbau Lindinger | Modellbau Lindinger | https://www.lindinger.at/de/Bauzubehoer-Mehr/Bauzubehoer-Kleinteile/Schrauben-Muttern-Scheiben/Schrauben-metrisch/Robbe-Modellsport-Zylinderkopfschrauben-Inne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 | 3.09 | 3.09 | lagernd (26.10.2026) | M3 x 20 mm | Produktseite Lindinger (Artikelname) | Annahme: Längen und Mengen sind ein Startsortiment; genaue Längen werden nach der Konstruktion nachgetragen; Hinterachse: 3 Stk (Verschraubung Gehäusehälften im Turm 1, Dämpfer oben 2)
21 | Verbindungselemente | Zylinderkopfschrauben Innensechskant M3x30, 30 Stk, Edelstahl | 1 | Pck | Zukauf | Robbe Modellsport | 50991113 (LI-9796365) | Edelstahl, M3, Zylinderkopf Innensechskant | Modellbau Lindinger | Modellbau Lindinger | https://www.lindinger.at/de/Bauzubehoer-Mehr/Bauzubehoer-Kleinteile/Schrauben-Muttern-Scheiben/Schrauben-metrisch/Robbe-Modellsport-Zylinderkopfschrauben-Inne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 | 3.39 | 3.39 | lagernd (26.10.2026) | M3 x 30 mm | Produktseite Lindinger (Artikelname) | Annahme: Längen und Mengen sind ein Startsortiment; genaue Längen werden nach der Konstruktion nachgetragen
22 | Verbindungselemente | Zylinderkopfschrauben Innensechskant M3x25, 10 Stk, Edelstahl | 1 | Pck | Zukauf | Planet-Hobby | 10090 (LI-34761) | Edelstahl rostfrei, M3, Zylinderkopf Innensechskant | Modellbau Lindinger | Modellbau Lindinger | https://www.lindinger.at/de/Bauzubehoer-Mehr/Bauzubehoer-Kleinteile/Schrauben-Muttern-Scheiben/Schrauben-metrisch/Planet-Hobby-INNENSECHSKANTSCHRAUBEN-M3-25MM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 | 1.49 | 1.49 | lagernd (26.10.2026) | M3 x 25 mm | Produktseite Lindinger (Artikelname) | Annahme: Längen und Mengen sind ein Startsortiment; genaue Längen werden nach der Konstruktion nachgetragen; Hinterachse: 4 Stk (Verschraubung Gehäusehälften unten 2, Bolzen Querlenker–Radträger 2); Vorderachse: 4 Stk (Bolzen Querlenker–C-Hub 2, Dämpfer oben 2); zusammen 8 von 10
23 | Verbindungselemente | Senkkopfschrauben Innensechskant M3x6, 30 Stk, Edelstahl | 1 | Pck | Zukauf | Robbe Modellsport | 50991130 (LI-9796382) | Edelstahl, M3, Senkkopf Innensechskant (u. a. Grundplatte) | Modellbau Lindinger | Modellbau Lindinger | https://www.lindinger.at/de/Bauzubehoer-Mehr/Bauzubehoer-Kleinteile/Schrauben-Muttern-Scheiben/Schrauben-metrisch/Robbe-Modellsport-Senkkopfschrauben-Innensec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 | 1.89 | 1.89 | lagernd (26.10.2026) | M3 x 6 mm | Produktseite Lindinger (Artikelname) | Annahme: Längen und Mengen sind ein Startsortiment; genaue Längen werden nach der Konstruktion nachgetragen; Mittelantrieb: 2 Stk M3 × 6 Senkkopf (Motor an die Motorplatte); greifen durch den 4-mm-Sockel nur ca. 2 mm ins Motorgewinde: Länge nach dem Messen der Gewindetiefe im Motorflansch festlegen (so lang wie möglich, ohne die Wicklung zu berühren; ggf. M3 × 8 aus Pos. 24), mit Schraubensicherung mittelfest (Pos. 67) auf der Werkbank anziehen (Nutzerentscheidung 2026-11-01)
24 | Verbindungselemente | Senkkopfschrauben Innensechskant M3x8, 30 Stk, Edelstahl | 2 | Pck | Zukauf | Robbe Modellsport | 50991131 (LI-9796383) | Edelstahl, M3, Senkkopf Innensechskant (u. a. Grundplatte) | Modellbau Lindinger | Modellbau Lindinger | https://www.lindinger.at/de/Bauzubehoer-Mehr/Bauzubehoer-Kleinteile/Schrauben-Muttern-Scheiben/Schrauben-metrisch/Robbe-Modellsport-Senkkopfschrauben-Innensec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 | 2.09 | 4.18 | lagernd (26.10.2026) | M3 x 8 mm | Produktseite Lindinger (Artikelname) | Grundplatte: 14 Stk M3 × 8 Senkkopf von unten (Akkuanschläge 10, Mittelstütze 4, klemmen auch den Stoß); weitere Längen nach der Konstruktion der übrigen Baugruppen; Hinterachse: 12 Stk M3 × 8 Senkkopf von unten (Getriebegehäuse 4, Querlenkerböcke 8); zusammen 26 von 30; Mittelantrieb: 5 Stk (Motorhalter von unten 3, Zahnradabdeckung unten an den Motorhalter von vorne 2, seit Review 2 statt M3 × 10: 4 mm Eingriff, 2 mm Reserve); zusammen 31, daher 2 Packungen; Vorderachse: 20 Stk M3 × 8 Senkkopf von unten (Frontschott 4, Querlenkerböcke 8, Lagerböcke 4, Servohalter 4); zusammen mehr als 30 → Menge 2 Pck; Karosseriehalter/Rammschutz: 4 Stk M3 × 8 Senkkopf von unten (Träger vorne/hinten auf das Lochbild Rammschutz ±8); zusammen 55 von 60
25 | Verbindungselemente | Senkkopfschrauben Innensechskant M3x10, 30 Stk, Edelstahl | 1 | Pck | Zukauf | Robbe Modellsport | 50991132 (LI-9796384) | Edelstahl, M3, Senkkopf Innensechskant (u. a. Grundplatte) | Modellbau Lindinger | Modellbau Lindinger | https://www.lindinger.at/de/Bauzubehoer-Mehr/Bauzubehoer-Kleinteile/Schrauben-Muttern-Scheiben/Schrauben-metrisch/Robbe-Modellsport-Senkkopfschrauben-Innensec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 | 2.19 | 2.19 | lagernd (26.10.2026) | M3 x 10 mm | Produktseite Lindinger (Artikelname) | Annahme: Längen und Mengen sind ein Startsortiment; genaue Längen werden nach der Konstruktion nachgetragen; Mittelantrieb: derzeit keine (Zahnradabdeckung unten seit Review 2 mit M3 × 8, Pos. 24; M3 × 10 hätte bei 4 mm Halterwand genau bis zum Grund der 6 mm tiefen Einsatzbohrung gereicht)
26 | Verbindungselemente | Senkkopfschrauben Innensechskant M3x14, 30 Stk, Edelstahl | 1 | Pck | Zukauf | Robbe Modellsport | 50991133 (LI-9796385) | Edelstahl, M3, Senkkopf Innensechskant (u. a. Grundplatte) | Modellbau Lindinger | Modellbau Lindinger | https://www.lindinger.at/de/Bauzubehoer-Mehr/Bauzubehoer-Kleinteile/Schrauben-Muttern-Scheiben/Schrauben-metrisch/Robbe-Modellsport-Senkkopfschrauben-Innensec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 | 2.29 | 2.29 | lagernd (26.10.2026) | M3 x 14 mm | Produktseite Lindinger (Artikelname) | Annahme: Längen und Mengen sind ein Startsortiment; genaue Längen werden nach der Konstruktion nachgetragen
27 | Verbindungselemente | Senkkopfschrauben Innensechskant M3x20, 30 Stk, Edelstahl | 1 | Pck | Zukauf | Robbe Modellsport | 50991134 (LI-9796386) | Edelstahl, M3, Senkkopf Innensechskant (u. a. Grundplatte) | Modellbau Lindinger | Modellbau Lindinger | https://www.lindinger.at/de/Bauzubehoer-Mehr/Bauzubehoer-Kleinteile/Schrauben-Muttern-Scheiben/Schrauben-metrisch/Robbe-Modellsport-Senkkopfschrauben-Innensec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 | 2.49 | 2.49 | lagernd (26.10.2026) | M3 x 20 mm | Produktseite Lindinger (Artikelname) | Annahme: Längen und Mengen sind ein Startsortiment; genaue Längen werden nach der Konstruktion nachgetragen; Karosseriehalter/Rammschutz: 4 Stk M3 × 20 Senkkopf von unten durch Grundplatte und Träger in die Karosseriepfosten (Lochbild Karosseriehalter ±22)
28 | Verbindungselemente | Stoppmuttern M3, 30 Stk, Edelstahl | 2 | Pck | Zukauf | Robbe Modellsport | 50991175 (LI-9796427) | Edelstahl, M3 | Modellbau Lindinger | Modellbau Lindinger | https://www.lindinger.at/de/Bauzubehoer-Mehr/Bauzubehoer-Kleinteile/Schrauben-Muttern-Scheiben/Muttern-Stoppmuttern/Robbe-Modellsport-Stoppmuttern-M3-30Stk.-E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 | 2.89 | 5.78 | lagernd (26.10.2026) | M3 | Produktseite Lindinger | Hinterachse: 4 Stk (Dämpfer oben 2, Bolzen Querlenker–Radträger 2); Vorderachse: 4 Stk (Dämpfer oben 2, Bolzen Querlenker–C-Hub 2)
29 | Verbindungselemente | Unterlegscheiben M3 3,2x7 mm, 30 Stk, Edelstahl | 1 | Pck | Zukauf | Robbe Modellsport | 50991056 (LI-9796308) | Edelstahl | Modellbau Lindinger | Modellbau Lindinger | https://www.lindinger.at/de/Bauzubehoer-Mehr/Bauzubehoer-Kleinteile/Schrauben-Muttern-Scheiben/Beilagscheiben-diverse-Scheiben/Robbe-Modellsport-Unterlegschei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 | 1.89 | 1.89 | lagernd (26.10.2026) | 3,2 x 7 mm | Produktseite Lindinger | Hinterachse: 4 Stk (Dämpferaugen); Vorderachse: 4 Stk (Dämpferaugen)
30 | Verbindungselemente | Gewindeeinsätze M3 kurz für 3D-Druck, 20 Stk | 6 | Pck | Zukauf | MP-JET | MPJ 1903 BR (LI-9795599) | Messing | Modellbau Lindinger | Modellbau Lindinger | https://www.lindinger.at/de/Bauzubehoer-Mehr/Bauzubehoer-Kleinteile/Schrauben-Muttern-Scheiben/Diverses-Befestigungsmaterial/MP-JET-Gewindeeinsatz-M3-kurz-20-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 | 8.49 | 25.47 | lagernd (26.10.2026) | Außendurchmesser, Länge und Bohrungsmaß am Teil messen | - | Menge ist Annahme (60 Stk); Grundplatte: 16 Stk (Akkuanschläge 10, Mittelstütze 6); Bohrung vorläufig Ø 4,0 × 6 mm, Maße bei Lieferung messen; Hinterachse: 30 Stk (Getriebegehäuse 16, davon 2 für den Lagerbock E2; Querlenkerböcke 8, Querlenker 2, Radträger 2, Dämpferbrücke 2); zusammen mit der Grundplatte 46 von 60; Mittelantrieb: 10 Stk (Motorhalter 6: Fuß 3, Klemmung 3; Zahnradabdeckung 4); zusammen 56 von 60; Vorderachse: 51 Stk (Frontschott 10, Querlenkerböcke 8, Querlenker 2, C-Hubs 2, Achsschenkel 6, Umlenkhebel 5, Lagerböcke 6, Servohalter 8, Servo-Saver 2, Dämpferbrücke 2); zusammen 107 → Menge 6 Pck (120); Karosseriehalter/Rammschutz: 12 Stk (Träger je 2 unten und 2 im Mittelsteg, Pfosten je 1); zusammen 119 von 120
31 | Elektronik | Fahrtenregler Hobbywing QuicRun WP10BL60 G2, sensorless, 60 A, 2-3S | 1 | Stk | Zukauf | Hobbywing | 30107300 | BEC 6 V/3 A Schaltregler; Abschaltung 3,2 oder 3,4 V/Zelle einstellbar; Vorwärts/Bremse/Rückwärts | Modellbau Lindinger | Modellbau Lindinger | https://www.lindinger.at/de/RC-Elektronik/Antriebe/Regler/HOBBYWING-QuicRun-WP10BL60-G2-Brushless-Regler-60A-2-3s-fuer-1-10/9801863 | 44.99 | 44.99 | lagernd (26.10.2026) | 46 x 36,5 x 34,3 mm; 86,6 g (Lindinger) bzw. 48,5 x 38 x 32 mm; 90 g (Hobbywing); Lüfter 30x30x10 mm; Eingang ohne Stecker | Produktseite Lindinger; Hobbywing Produktseite und Anleitung | XT60 anlöten; Maßangaben weichen ab: am Teil messen
32 | Elektronik | Motor Hobbywing QuicRun 3652SL G2, sensorless, 3250 kV | 1 | Stk | Zukauf | Hobbywing | 30404400 | 4-polig, 2-3S | Modellbau Lindinger | Modellbau Lindinger | https://www.lindinger.at/de/Fahrzeuge-Boote/Fahrzeug-Antriebe/Elektromotoren/HOBBYWING-QuicRun-3652SL-G2-Sensorless-Motor-3250kV-3.175mm-Welle/9796158 | 32.99 | 32.99 | nur noch wenige lagernd (26.10.2026) | Ø 36 mm, Länge 52 mm, Welle 3,175 x 15 mm, 223 g; Lochbild am Teil messen | Produktseite Lindinger | Ritzel Modul 0,6 mit Bohrung 3,17 mm passt auf die 3,175-mm-Welle
33 | Elektronik | ELRS-Empfänger HelloRadio HR7E, 8 PWM-Ausgänge | 1 | Stk | Zukauf | HelloRadio | HR2004 (LI-9811430) | ExpressLRS 3.3.0 vorinstalliert, 4,5-8,4 V; für EU mit Regulatory Domain EU_CE_2400 (LBT) flashen | Modellbau Lindinger | Modellbau Lindinger | https://www.lindinger.at/de/RC-Elektronik/RC-Produkte/Empfaenger/HelloRadio-HR7E-ELRS-2-4GHz-Empfaenger-8-Kanaele-rot/9811430 | 24.90 | 24.90 | lagernd (26.10.2026) | 46 x 26 x 15 mm; 12,7 g; Antenne 18 cm | Produktseite Lindinger | Failsafe Kanal 2 auf 1500 µs einstellen
34 | Elektronik | Lenkservo Savöx SC-1258TG+, Standardgröße, 25Z | 1 | Stk | Zukauf | Savöx | SC-1258TG+ | Titangetriebe; 12 kg·cm und 0,08 s/60° bei 6 V; 4,8-6,0 V | Modellbau Lindinger | Modellbau Lindinger | https://www.lindinger.at/de/RC-Elektronik/Servos-Zubehoer/Servos-Digital-Low-Voltage/SAVOEX-SC-1258TG-6V-12KG-0-08s-DIGITAL-SERVO/9795331 | 54.99 | 54.99 | lagernd (26.10.2026) | 40,3 x 20,2 x 37,2 mm; 64 g; Abtrieb 25Z/6,0 mm; Lochabstand der Laschen und Höhe der Abtriebswelle am Teil messen | Produktseite Lindinger | Blockierstrom 5000 mA bei 6,0 V (englische Lindinger-Produktseite: https://lindinger.at/en/RC-ELECTRONICS/Servos-Accessories/Servos-Digital-Low-Voltage/SAVOEX-SC-1258TG-6V-12KG-0.08s-DIGITAL-SERVO/9795331) > BEC 3 A → Versorgung über externen UBEC (nächste Zeile, Nutzerentscheidung 2026-10-27)
35 | Elektronik | Externer BEC Hobbywing UBEC 10A V2, 2-6S, Ausgang 6,0 V | 1 | Stk | Zukauf | Hobbywing | 30603003 (HW30603003) | Schaltregler, 10 A Dauer / 15 A Spitze, Eingang 6-25,2 V, Ausgang 6,0/7,4/8,4 V einstellbar → 6,0 V | RC Team (rcteam.com) | RC Team (rcteam.com) | https://www.rcteam.com/en/products/hobbywing-ubec-10a-v2-2-6s-30603003 | 29.90 | 29.90 | verfügbar laut Shop (26.10.2026) | 43,1 x 32,3 x 12,5 mm (RC Team) bzw. 45 x 20 x 16,2 mm (htmodel.sk), widersprüchlich: am Teil messen; 34 g | Produktseite rcteam; Produktseite htmodel.sk | Nutzerentscheidung 2026-10-27; versorgt Empfänger und Servo; Eingang an die Akkuleitung des Reglers (XT60) anlöten; rote Ader des Regler-Steuerkabels am Empfänger abziehen. Ein/Aus-Schalter laut Quellen widersprüchlich: am Teil prüfen. Reglerschalter schaltet Empfänger und Servo nicht ab: Akku nach der Fahrt sofort abstecken
36 | Elektronik | LiPo-Akku Voltz 2S 7,4 V 5000 mAh 50C, Hardcase, XT60 | 1 | Stk | Zukauf | Voltz | VZ0317XT60 | Hardcase | RC Team (rcteam.com) | RC Team (rcteam.com) | https://www.rcteam.com/en/products/voltz-lipo-5000mah-2s-7-4v-50c-hard-case-xt60-battery | 36.90 | 36.90 | verfügbar laut Shop (26.10.2026) | 138 x 46 x 25 mm; 300 g; XT60 | Produktseite rcteam | LiPo-Versand aus Frankreich vor Bestellung prüfen
37 | Elektronik | XT60-Steckerpaar (Stecker für Regler, Buchse) | 1 | Pck | Zukauf | Revtec/GForce | GF-1003-001 | vergoldet | RC Team (rcteam.com) | RC Team (rcteam.com) | https://www.rcteam.com/en/products/gforce-connector-xt60-male-vario-female-battery-gf-1003-001 | 6.50 | 6.50 | verfügbar laut Shop (26.10.2026) | am Teil messen | - (keine Maßangabe übernommen) | für den Reglereingang; Inhalt laut RC Team: 2 male / 2 female (2 Paare)
38 | Elektronik | Servo-Verlängerung 10 cm, 2 Stk | 1 | Pck | Zukauf | Powerbox Systems | 1562/10 (LI-9775611) | - | Modellbau Lindinger | Modellbau Lindinger | https://www.lindinger.at/de/POWERBOX-SYSTEMS-Premium-Servo-Verlaengerung-2-Stueck-Laenge-10cm/9775611 | 9.40 | 9.40 | lagernd (26.10.2026) | Länge 10 cm | Produktseite Lindinger
39 | Elektronik | Kabelbinder 100 x 2,5 mm, 100 Stk | 1 | Pck | Zukauf | Planet-Hobby | E561 (LI-9718757) | schwarz | Modellbau Lindinger | Modellbau Lindinger | https://www.lindinger.at/de/Bauzubehoer-Mehr/Bauzubehoer-Kleinteile/Klett-Kabelbinder-Gummiringe/Planet-Hobby-KABELBINDER-100-2-5MM-100STK.-SCHWARZ/9718757 | 1.00 | 1.00 | nur noch wenige lagernd (26.10.2026) | 100 x 2,5 mm | Produktseite Lindinger
40 | Elektronik | LiPo-Schutztasche Lipoguard L | 1 | Stk | Zukauf | Robbe Modellsport | 90340076 (LI-9811107) | für Laden und Lagern | Modellbau Lindinger | Modellbau Lindinger | https://www.lindinger.at/de/RC-Elektronik/Antriebe/Akkus/Robbe-Modellsport-Lipoguard-L-Lipo-Tasche-ca.-215x155x110-Hochwertige-Ausfuehrung/9811107 | 19.99 | 19.99 | lagernd (26.10.2026) | ca. 215 x 155 x 110 mm | Produktseite Lindinger
41 | Grundplatte | Grundplatte hinten und vorne (Druck, zweiteilig, Stoß mit Halbüberlappung) | 1 | Stk | Druck | Eigenbau |  | PETG (Probemontage), Prusament PC (fertig); 4 mm; Aluvariante siehe Pos. 56 | print/stl/chassis-grundplatte-hinten.stl, print/stl/chassis-grundplatte-vorne.stl |  |  |  |  | konstruiert | 99,4 g + 98,9 g (PETG, 100 % Füllung) | Fusion, Volumen × 1,27 g/cm³ | Eigenbau, docs/grundplatte-oberdeck.md (Fassung 2, TT-02B); hinten flach auf dem Bett, vorne kopfüber drucken; je 191,8 × 144 mm (Plattenlänge 354 mm, Überstand 20 mm seit 2026-11-13); Fügespiel am Stoß 0,2 mm je Stufe
42 | Grundplatte | Oberdeck | 1 | Stk | Druck | Eigenbau |  | PETG (Probemontage), Prusament PC (fertig); 3 mm | print/stl/chassis-oberdeck.stl |  |  |  |  | konstruiert | 20,7 g (PETG, 100 % Füllung) | Fusion, Volumen × 1,27 g/cm³ | Eigenbau, docs/grundplatte-oberdeck.md; Unterkante Z 84,2 mm auf beiden Achsgetrieben und der Mittelstütze (Pos. 54); 6 × M3 × 8 Zylinderkopf (Pos. 17) in Gewindeeinsätze
43 | Antrieb hinten | Getriebe- und Differentialgehäuse hinten, zweiteilig (links/rechts) | 1 | Satz | Druck | Eigenbau |  | PETG (Test), Prusament PC (fertig); Gewindeeinsätze M3 (Pos. 30) | print/stl/hinterachse-getriebegehaeuse-links.stl, print/stl/hinterachse-getriebegehaeuse-rechts.stl |  |  |  |  | konstruiert | 31,0 g + 31,5 g (PETG, 100 % Füllung; Version 14) | Fusion, Volumen × 1,27 g/cm³ | Eigenbau, docs/hinterachse.md; nimmt Diff (2 × 8x12x3,5) und das hintere Lager 5x11x4 der Kegelritzelwelle E2 auf (vorderes Lager im Lagerbock, Pos. 64); Hälften mit 4 × M3 quer verschraubt (Pos. 19, 20, 22); Verschraubung vorne oben seit Version 14 hinter der Oberdeck-Auflage (X −120,2 / Z 79,8, montierbar, Review 2 Mittelantrieb); hinterer E2-Sitz als Festlager geklemmt (ha_e2h_spiel); auf der Teilungsfläche drucken, Stützen nur im Zahnraum; erst nach dem Messen drucken (Nutzerentscheidung 2026-11-01, Zahnradraum offen)
44 | Antrieb hinten | Radträger hinten links/rechts | 2 | Stk | Druck | Eigenbau |  | PETG (Test), Prusament PC (fertig); Gewindeeinsätze M3 (Pos. 30) | print/stl/hinterachse-radtraeger-links.stl, print/stl/hinterachse-radtraeger-rechts.stl |  |  |  |  | konstruiert | je 6,3 g (PETG, 100 % Füllung) | Fusion, Volumen × 1,27 g/cm³ | Eigenbau, docs/hinterachse.md; 2 Lager 5x11x4 für die Radachse N1, Vorspur 2° fest; Bolzen M3 × 25 zum Querlenker, Kugelkopf 5 mm (Pos. 62) für die Sturzstange
45 | Fahrwerk | Querlenker hinten links/rechts (unten) | 2 | Stk | Druck | Eigenbau |  | PETG (Test), Prusament PC (fertig); Gewindeeinsätze M3 (Pos. 30) | print/stl/hinterachse-querlenker-links.stl, print/stl/hinterachse-querlenker-rechts.stl |  |  |  |  | konstruiert | je 9,7 g (PETG, 100 % Füllung) | Fusion, Volumen × 1,27 g/cm³ | Eigenbau, docs/hinterachse.md; Sollbruchstelle der Hinterachse; Hebelverhältnis Rad:Dämpfer 1,76; vorne siehe Pos. 57
46 | Fahrwerk | Dämpferbrücke hinten | 1 | Stk | Druck | Eigenbau |  | PETG (Test), Prusament PC (fertig); später Alu (Fräs, 2,5D); 2 Gewindeeinsätze M3 | print/stl/hinterachse-daempferbruecke.stl |  |  |  |  | konstruiert | 31,2 g (PETG, 100 % Füllung) | Fusion, Volumen × 1,27 g/cm³ | Eigenbau, docs/hinterachse.md; Platte 6 mm an der Gehäuserückseite (4 × M3 × 10), Dämpfer hinten, Kugelköpfe der Sturzstangen vorne; vorne siehe Pos. 58
47 | Mittelantrieb | Mittelschott mit Lagerung Rutschkupplung | 1 | Stk | Druck | Eigenbau |  | PA-CF o. ä. | - |  |  |  |  | entfällt | - |  | ENTFÄLLT im TT-02B-Layout (Kardanwelle nur an den Getrieben gelagert, docs/skelett.md); Auflage des Oberdecks übernimmt die Mittelstütze (Pos. 54)
48 | Mittelantrieb | Rutschkupplung (v1 entfällt, später eigene Anforderung) | 1 | Stk | Druck | Eigenbau |  | PA-CF o. ä.; Normteile (Druckfeder, Reibbelag, Lager) laut Anforderungsanalyse Mittelantrieb | - |  |  |  |  | entfällt (v1) | - |  | V1 ENTFÄLLT (Nutzerentscheidung 2026-11-01): v1 fährt mit Mitnehmer GB3 und Hauptzahnrad GB5 aus dem Bausatz wie der TT-02B, Schonung über die Reglereinstellung; die Rutschkupplung braucht ca. 30 mm auf E2 und kommt später als eigene Anforderung (docs/plan.md, Phase 2)
49 | Mittelantrieb | Motorhalter mit Zahnspiel-Einstellung (Vorderwand der Zahnradabdeckung) | 1 | Stk | Druck | Eigenbau |  | Prusament PC (PETG nur Passprobe), fräsgerecht 2,5D für spätere Alu-Version; 3 × M3 × 8 Senkkopf von unten (Pos. 24), 6 Gewindeeinsätze (Pos. 30) | print/stl/mittelantrieb-motorhalter.stl |  |  |  |  | konstruiert | 22,1 g (PC, 100 % Füllung) | Fusion, Volumen × 1,20 g/cm³ | Eigenbau, docs/mittelantrieb.md; Fuß auf das Lochbild der Grundplatte (−71 / −40,5; −28,5; −16,5), Fenster für den Sockel der Motorplatte, Bodenleiste vor dem Lagerbock (bis zur Grundplatte), Wand unten bis zur Grundplatte, Durchgänge der Lagerbock-Schrauben Ø 7,5 mit Engstelle Ø 6,5 hinten (Ringspalt 0,5 mm am Kopf); Lappen mit Steg links unten für die Schraube der Zahnradabdeckung unten links (Review 2, Version 8); Druck: Fuß auf dem Bett; erst nach dem Messen drucken
50 | Mittelantrieb | Zahnradabdeckung (Oberteil, Unterteil links, Unterteil rechts) | 1 | Satz | Druck | Eigenbau |  | PETG (Test), Prusament PC (fertig); 2 × M3 × 8 Senkkopf vom Halter (Pos. 24), 2 × M3 × 8 Zylinderkopf an den Laschen (Pos. 17), 4 Gewindeeinsätze (Pos. 30) | print/stl/mittelantrieb-zahnradabdeckung-oben.stl, print/stl/mittelantrieb-zahnradabdeckung-unten-links.stl, print/stl/mittelantrieb-zahnradabdeckung-unten-rechts.stl |  |  |  |  | konstruiert | 10,1 g (PC, 100 % Füllung; Oberteil 6,0, unten links 1,6, unten rechts 2,4; Version 9) | Fusion, Volumen × 1,20 g/cm³ | Eigenbau, docs/mittelantrieb.md; Schutz vor drehenden Teilen (Pflicht); vorne vom Motorhalter geschlossen, hinten an Getriebegehäuse und Lagerbock angepasst; Oberteil senkrecht auf- und abnehmbar (die obere Gehäuseschraube liegt seit Hinterachse v14 hinter der Oberdeck-Auflage, 4,45 mm von der Abdeckung); Druck: Rückwand auf dem Bett; erst nach dem Messen drucken
51 | Vorderachse | Achsschenkel vorne links/rechts (lenkung-achsschenkel) | 2 | Stk | Druck | Eigenbau |  | PETG (Test), Prusament PC (fertig); Gewindeeinsätze M3 (Pos. 30); je 2 Lager 5x11x4 (Pos. 14), 2 Kingpin-Passschrauben (Pos. 75) | print/stl/lenkung-achsschenkel-links.stl, print/stl/lenkung-achsschenkel-rechts.stl |  |  |  |  | konstruiert | links 5,5 g, rechts 5,4 g (PETG, 100 % Füllung) | Fusion, Volumen × 1,27 g/cm³ | Eigenbau, docs/vorderachse.md; Spurhebel mit Kugelkopf 5 mm (hängend), Radachse N1 (Pos. 8) axial über Lagersteg, Becher und Mitnehmer gesichert; links und rechts eigene Spurhebelgeometrie
52 | Vorderachse | Umlenkhebel links/rechts (Lenkhebelsystem) | 2 | Stk | Druck | Eigenbau |  | PETG (Test), Prusament PC (fertig); Gewindeeinsätze M3 (Pos. 30); je 2 Lager 5x8x2,5 (Pos. 15) auf Messinghülse (Pos. 76) und M3 × 14 (Pos. 19) | print/stl/lenkung-umlenkhebel-links.stl, print/stl/lenkung-umlenkhebel-rechts.stl |  |  |  |  | konstruiert | links 2,8 g, rechts 3,5 g (PETG) | Fusion, Volumen × 1,27 g/cm³ | Eigenbau, docs/vorderachse.md; Servo-Saver, Lagerböcke und Servohalter als eigene Positionen (Pos. 70–73)
53 | Elektronik | Halter für Regler, Empfänger und Akku | 1 | Stk | Druck | Eigenbau |  | PETG | print/stl/elektronik-*.stl (geplant) |  |  |  |  |  | wird konstruiert |  | Eigenbau
54 | Grundplatte | Mittelstütze (Auflage Oberdeck, klemmt den Stoß) | 1 | Stk | Druck | Eigenbau |  | PETG (Probemontage), Prusament PC (fertig); 6 Gewindeeinsätze M3 (Pos. 30) | print/stl/chassis-mittelstuetze.stl |  |  |  |  | konstruiert | 17,6 g (PETG, 100 % Füllung) | Fusion, Volumen × 1,27 g/cm³ | Eigenbau, docs/grundplatte-oberdeck.md; ersetzt das Mittelschott (Pos. 47) als Auflage des Oberdecks; auf der Seitenfläche liegend drucken
55 | Grundplatte | Akkuanschläge links, rechts, vorne, hinten | 4 | Stk | Druck | Eigenbau |  | PETG (Probemontage), Prusament PC (fertig); 10 Gewindeeinsätze M3 (Pos. 30) | print/stl/chassis-akkuanschlag-links.stl, -rechts.stl, -vorne.stl, -hinten.stl |  |  |  |  | konstruiert | 15,0 g gesamt (PETG, 100 % Füllung) | Fusion, Volumen × 1,27 g/cm³ | Eigenbau, docs/grundplatte-oberdeck.md; Anschlag vorne wird später durch den vorderen Akkubügel-Pfosten ersetzt (Nutzerentscheidung 2026-10-28); Anschläge links/rechts klemmen mit dem mittleren Loch den Stoß
56 | Grundplatte | Grundplatte Aluvariante (einteilig, Phase 3) | 1 | Stk | Frästeil | Eigenbau |  | Alu 6061, 4 mm; ersetzt in Phase 3 die Druckteile Pos. 41 | cad/step/chassis-grundplatte-alu.step |  |  |  |  | konstruiert, CAM offen (Phase 3) | 421,9 g (Alu 6061) | Fusion, Volumen × 2,70 g/cm³ | Eigenbau, docs/grundplatte-oberdeck.md; Körper grundplatte-alu, 354 × 144 mm; Bohr-NC, Senken und CAM-Simulation in Phase 3 (Nutzerentscheidungen 2026-10-28)
57 | Vorderachse | Querlenker vorne links/rechts (unten) | 2 | Stk | Druck | Eigenbau |  | PETG (Test), Prusament PC (fertig); Gewindeeinsätze M3 (Pos. 30); Sollbruchstelle | print/stl/vorderachse-querlenker-links.stl, print/stl/vorderachse-querlenker-rechts.stl |  |  |  |  | konstruiert | je 8,3 g (PETG) | Fusion, Volumen × 1,27 g/cm³ | Eigenbau, docs/vorderachse.md; Stift 3 × 40 (Pos. 60), Bolzen M3 × 25 + Stoppmutter zum C-Hub, Dämpfer unten M3 × 14
58 | Vorderachse | Dämpferbrücke vorne | 1 | Stk | Druck | Eigenbau |  | PETG (Test), Prusament PC (fertig); später Alu (Fräs, 2,5D, Prüfskript); 2 Gewindeeinsätze M3 | print/stl/vorderachse-daempferbruecke.stl |  |  |  |  | konstruiert | 30,1 g (PETG) | Fusion, Volumen × 1,27 g/cm³ | Eigenbau, docs/vorderachse.md; 4 × M3 × 10 an das Frontschott, Dämpfer oben M3 × 25 + Distanzhülse 6 mm (Pos. 77) + Stoppmutter, Kugelköpfe der Sturzstangen hinten
59 | Fahrwerk | Querlenkerböcke hinten (links/rechts, vor/hinter der Achse) | 4 | Stk | Druck | Eigenbau |  | PETG (Test), Prusament PC (fertig); Gewindeeinsätze M3 (Pos. 30) | print/stl/hinterachse-querlenkerbock-links-hinten.stl, -links-vorne.stl, -rechts-hinten.stl, -rechts-vorne.stl |  |  |  |  | konstruiert | je 3,3 g (PETG, 100 % Füllung) | Fusion, Volumen × 1,27 g/cm³ | Eigenbau, docs/hinterachse.md; je 2 × M3 × 8 Senkkopf von unten (Pos. 24) auf die Fußflächen der Grundplatte; 2,5D; auf der Seitenfläche drucken
60 | Fahrwerk | Zylinderstift ISO 2338 3 m6 × 40 (Querlenkerachsen hinten und vorne) | 4 | Stk | Normteil |  | ISO 2338 | Stahl, Ø 3 m6 × 40 mm | manuell suchen (Normteile-Shop, z. B. Zylinderstift DIN EN ISO 2338 3 × 40) | manuell suchen |  |  |  | manuell suchen | Ø 3 × 40 mm | Norm | docs/hinterachse.md; Stift steckt in Sacklöchern der Böcke und ist nach dem Verschrauben axial gefangen. MANUELL SUCHEN: bei TAMICO, Lindinger und RC Team nicht nachweisbar (Websuche 01.11.2026); Normteil, z. B. aus einem Normteile-Versand; Ersatz: Silberstahl Ø 3 mm auf 40 mm gekürzt; Vorderachse: 2 Stk (Querlenkerachse vorne) → Menge 4
61 | Fahrwerk | Spannschloss-Satz Tamiya TT-02B (Turnbuckle All Set) für die Sturzstangen hinten | 1 | Satz | Zukauf | Tamiya | 54539 (OP.1539) | 7 Spannschlösser (2 × obere Lenker hinten, 2 × vorne, 2 × Spurstangen, 1 × Lenkgestänge): 4 × Edelstahl 3 × 32 mm, 3 × 3 × 23 mm, 7 Kugelpfannen 5 mm, Schlüssel | manuell suchen | manuell suchen | https://www.tamiyausa.com/shop/alumti-turnbuckles/rc-tt02b-full-turnbuckle-set/ |  |  | in TAMICO, Lindinger und RC Team nicht nachweisbar (Websuche 01.11.2026) | Kugelmitte–Kugelmitte hinten 50,95 mm (Konstruktion) | docs/hinterachse.md; Inhalt laut Tamiya USA (Link, Herstellerseite, kein Shop) | MANUELL SUCHEN (Richtpreis UVP 20 USD laut Tamiya USA; EAN 4950344545391). Zukauf, weil der Bausatz 58568 hinten nur starre obere Lenker C2 und keine Sturzstangen hat (Nutzerentscheidung 2026-11-01, MECH-HAC-006). Hinten: 2 × 3 × 32 mm. Länge und Pfannen bei Lieferung prüfen; Vorderachse: 2 × 3 × 32 mm als Sturzstangen vorne (Kugelmitte–Kugelmitte 49,46 mm), 2 × 3 × 23 mm als Spurstangen (43,55 / 43,39 mm), 1 × 3 × 23 mm als Servo-Anlenkung (39,94 mm, unteres Ende des Verstellwegs); das Lenkgestänge zwischen den Umlenkhebeln (96,76 mm) deckt der Satz nicht ab → Ersatz Pos. 78
62 | Fahrwerk | Kugelköpfe 5 mm M3, 10 Stk (Tamiya, wie MB8) für die Sturzstangen hinten | 2 | Pck | Zukauf | Tamiya | 50592 (300050592, LI-39784) | 5-mm-Kugelkopf, Gewinde 3 mm | Modellbau Lindinger | Modellbau Lindinger | https://www.lindinger.at/de/Fahrzeuge-Boote/Auto-Ersatzteile-Tuning/TAMIYA-5mm-Kugelkopf-M3-10/39784 | 4.99 | 4.99 | Bestellware, keine Lagerware (01.11.2026) | Kugelmitte 6 mm über Auflage (vorläufig, ha_kugel_h) | docs/hinterachse.md; Produktseite Lindinger (MPN 300050592) | 4 von 10 verbaut: 2 in der Dämpferbrücke, 2 in den Radträgern (je Gewindeeinsatz M3); die 4 MB8 des Bausatzes braucht die Lenkung; Vorderachse: 12 Kugelköpfe (Sturzstangen 4, Spurstangen 4, Lenkgestänge 2, Servo-Anlenkung 2); mit den 4 MB8 aus Pos. 11 fehlen 2 → Menge 2 Pck
63 | Antrieb hinten | Passscheiben zum Einstellen des Zahneingriffs, Innendurchmesser 5 mm (E2) und 8 mm (Diff), Stärken 0,1/0,2/0,3 mm (Stapel ca. 0,5 mm vorgesehen) | 1 | Satz | Normteil |  | DIN 988 | Stahl, 5 × 10 mm und 8 × 12 mm | 5 × 10 × 0,2: Modellbau Lindinger (KRICK 820297); 8 × 12 und weitere Stärken: manuell suchen | Modellbau Lindinger | https://www.lindinger.at/de/Fahrzeuge-Boote/Auto-Ersatzteile-Tuning/KRICK-Pass-Scheiben-5x10x0-2-10Stk/43433 | 5.40 | 5.40 | 5 × 10 × 0,2: Bestellware, keine Lagerware (01.11.2026); 8 × 12: in TAMICO, Lindinger und RC Team nicht nachweisbar | im Modell 0,5 mm zwischen Kegelritzel und hinterem E2-Lager (ha_e2_scheibe) und je Seite zwischen Diff und Diff-Lager (ha_diff_spalt), vorläufig | docs/hinterachse.md | docs/hinterachse.md (MECH-HAC-002): zwischen Lager und Kegelritzel bzw. Diff; erst wenn Scheiben nicht reichen, ha_e2_einbau / ha_diff_versatz ändern. 8 × 12 MANUELL SUCHEN (Normteil DIN 988)
64 | Antrieb hinten | Lagerbock für das vordere Lager der Kegelritzelwelle E2 (abnehmbar) | 1 | Stk | Druck | Eigenbau |  | PETG (Test), Prusament PC (fertig); 2 × M3 × 14 Zylinderkopf (Pos. 19) in Gewindeeinsätze im Getriebegehäuse (Pos. 30) | print/stl/hinterachse-getriebegehaeuse-lagerbock.stl |  |  |  |  | konstruiert | 3,5 g (PETG, 100 % Füllung) | Fusion, Volumen × 1,27 g/cm³ | Eigenbau, docs/hinterachse.md; Nutzerentscheidung 2026-11-01 (Lagerung wie Bauanleitung: Becher, Lager, Hauptzahnrad/Rutschkupplung, Lager, Kegelritzel); seit Review 2 ohne Lippe, Steg 18 × 3,5 mm, vorderes Lager liegt am Becher an (Loslager); Vorderseite auf dem Bett drucken, ohne Stützen; erst nach dem Messen drucken (Nutzerentscheidung 2026-11-01, Zahnradraum offen)
65 | Mittelantrieb | Motorplatte mit Sockel, Klemmrand und Becherhaube | 1 | Stk | Druck | Eigenbau |  | Prusament PC (PETG nur Passprobe); Motor mit 2 × M3 × 6 Senkkopf (Pos. 23, Länge nach dem Messen, Schraubensicherung Pos. 67), Klemmung 3 × M3 × 8 Zylinderkopf (Pos. 17) in Langlöchern | print/stl/mittelantrieb-motorplatte.stl |  |  |  |  | konstruiert | 9,5 g (PC, 100 % Füllung) | Fusion, Volumen × 1,20 g/cm³ | Eigenbau, docs/mittelantrieb.md; trägt den Motor, gleitet zur Zahnspiel-Einstellung radial zur E2-Achse; Becherhaube umschließt den Becher E2 (Motordose als Wand, Nutzerentscheidung 2026-11-01); Druck: Sockel-Rückseite auf dem Bett, Stützen unter dem Rand
66 | Mittelantrieb | Blinddeckel für die E1-Öffnung der Becherhaube | 1 | Stk | Druck | Eigenbau |  | PETG oder Prusament PC, Presssitz | print/stl/mittelantrieb-blinddeckel.stl |  |  |  |  | konstruiert | 1,7 g (PC, 100 % Füllung) | Fusion, Volumen × 1,20 g/cm³ | Eigenbau, docs/mittelantrieb.md; verschließt in v1 die Öffnung für die Kardanwelle E1, für 4WD entfernen (MECH-MAN-006, -021); Passung per Probedruck
67 | Verbindungselemente | Schraubensicherung mittelfest (z. B. Loctite 243) | 1 | Stk | Zukauf |  |  | mittelfest, lösbar, für Metallgewinde | manuell suchen | manuell suchen |  |  |  | - | - | - | Mittelantrieb: Schrauben Motor ↔ Motorplatte (Pos. 23) und Madenschraube des Motorritzels; Nutzerentscheidung 2026-11-01 (Review B1); nicht an Kunststoffgewinden bzw. Gewindeeinsätzen in PC verwenden
68 | Vorderachse | Frontschott (Platzhalter für das Vorderachsgetriebe, trägt Oberdeck und Dämpferbrücke) | 1 | Stk | Druck | Eigenbau |  | PETG (Test), Prusament PC (fertig); Gewindeeinsätze M3 (Pos. 30) | print/stl/vorderachse-frontschott.stl |  |  |  |  | konstruiert | 30,3 g (PETG) | Fusion, Volumen × 1,27 g/cm³ | Eigenbau, docs/vorderachse.md; Nutzerentscheidung 2026-11-08; 4 × M3 × 8 Senkkopf von unten, Oberdeck 2 × M3 × 8; wird für 4WD durch das Getriebe ersetzt
69 | Vorderachse | Querlenkerböcke vorne (links/rechts, vor/hinter der Achse) | 4 | Stk | Druck | Eigenbau |  | PETG (Test), Prusament PC (fertig); Gewindeeinsätze M3 (Pos. 30) | print/stl/vorderachse-querlenkerbock-*.stl |  |  |  |  | konstruiert | je 2,8 g (PETG) | Fusion, Volumen × 1,27 g/cm³ | Eigenbau, docs/vorderachse.md; je 2 × M3 × 8 Senkkopf von unten
70 | Vorderachse | C-Hub vorne links/rechts (Achsschenkelträger, Nachlauf fest) | 2 | Stk | Druck | Eigenbau |  | PETG (Test), Prusament PC (fertig); Gewindeeinsätze M3 (Pos. 30) | print/stl/vorderachse-c-hub-links.stl, print/stl/vorderachse-c-hub-rechts.stl |  |  |  |  | konstruiert | je 4,0 g (PETG) | Fusion, Volumen × 1,27 g/cm³ | Eigenbau, docs/vorderachse.md; Nachlauf 4° fest; Kugelkopf der Sturzstange stehend
71 | Lenkung | Lagerböcke Umlenkhebel links/rechts | 2 | Stk | Druck | Eigenbau |  | PETG (Test), Prusament PC (fertig); Gewindeeinsätze M3 (Pos. 30) | print/stl/lenkung-lagerbock-links.stl, print/stl/lenkung-lagerbock-rechts.stl |  |  |  |  | konstruiert | je 4,5 g (PETG) | Fusion, Volumen × 1,27 g/cm³ | Eigenbau, docs/vorderachse.md; je 2 × M3 × 8 Senkkopf von unten, Achse M3 × 14 mit Messinghülse (Pos. 76)
72 | Lenkung | Servohalter Savöx SC-1258TG+ | 1 | Stk | Druck | Eigenbau |  | PETG (Test), Prusament PC (fertig); Gewindeeinsätze M3 (Pos. 30) | print/stl/lenkung-servohalter.stl |  |  |  |  | konstruiert | 11,8 g (PETG) | Fusion, Volumen × 1,27 g/cm³ | Eigenbau, docs/vorderachse.md; 4 × M3 × 8 Senkkopf von unten, Servo mit 4 × M3 × 8 Zylinderkopf an den Laschen
73 | Lenkung | Servo-Saver Eigenbau: Nabe und Arm | 1 | Satz | Druck | Eigenbau |  | Prusament PC (PETG nur Probe); 2 Gewindeeinsätze M3 | print/stl/lenkung-servo-saver-nabe.stl, print/stl/lenkung-servo-saver-arm.stl |  |  |  |  | konstruiert | Nabe 3,0 g, Arm 2,0 g (PETG) | Fusion, Volumen × 1,27 g/cm³ | Eigenbau, docs/vorderachse.md; Nutzerentscheidung 2026-11-08; Rastnocken 45°, Auslösemoment 0,4 Nm einstellbar; Nabe mit 2 × M3 × 8 am Alu-Horn (Pos. 74), Vorspannschraube M3 × 12 mit Scheibe DIN 9021
74 | Lenkung | Alu-Servohorn 25Z doppelt (Savöx) | 1 | Stk | Zukauf | Savöx | Servohebel Alu doppelt 25T (LI-9802568) | Alu, 25Z, für SC-1258TG+ | Modellbau Lindinger | Modellbau Lindinger | https://lindinger.at/en/RC-Electronics/RC-Systems/Servos/SAVOEX-Servohebel-Alu-doppelt-25T-Servo-Horn-Double-Sided-Alu-High-Torque-25T/9802568 |  |  | Preis und Verfügbarkeit prüfen | - | - | Trägt die Saver-Nabe; Lochkreis vorläufig r 7,5 mm (va_horn_loch_r), Arme auf 24 mm kürzen; Maße am Teil messen
75 | Vorderachse | Passschraube ISO 7379 Bund Ø 4 × 5, Gewinde M3 (Kingpin) | 4 | Stk | Normteil |  | ISO 7379 | Stahl, Bund 4 h8, Gewinde M3, Kopf vorläufig Ø 7 × 3 | manuell suchen (Normteile-Shop, z. B. Passschrauben ISO 7379 Ø 4) | manuell suchen |  |  |  | manuell suchen | - | - | Kingpin oben und unten je Seite: Bund im C-Hub-Ohr (Bohrung Ø 4,1), Gewinde in den Einsatz im Achsschenkel; Bundlänge 5 mm mit Passscheibe 4 × 8 × 0,8 auf 4,2 mm Ohr + Luft ausgleichen (am Teil prüfen)
76 | Lenkung | Messingrohr 5 × 0,9 mm (Lagerhülse Umlenkhebel), 2 × 9 mm abgelängt | 1 | Stk | Normteil |  |  | Messing, Ø 5 außen, Ø 3,2 innen, 9 mm lang | manuell suchen (Modellbau-Halbzeug, Messingrohr 5 × 0,9) | manuell suchen |  |  |  | manuell suchen | - | - | Innenringe der Lager 5x8x2,5 sitzen auf der Hülse, M3 × 14 durch die Hülse in den Einsatz des Lagerbocks; oben Scheibe DIN 433 M3 (Ø 6) nur auf dem Innenring
77 | Vorderachse | Distanzhülse M3 × 6 mm (Dämpfer oben vorne) | 2 | Stk | Normteil |  |  | Alu oder Kunststoff, Ø 3,2 innen, 6 mm | manuell suchen | manuell suchen |  |  |  | manuell suchen | - | - | Zwischen Dämpferbrücke und oberem Dämpferauge (va_d_distanz), damit der Dämpferkörper frei vor der Brücke liegt
78 | Lenkung | Lenkgestänge: Gewindestange M3 (DIN 976, Edelstahl) ca. 78 mm mit 2 Kugelpfannen 5 mm | 1 | Satz | Normteil |  | DIN 976-1 | Edelstahl M3; Kugelpfannen 5 mm mit M3-Innengewinde | manuell suchen (Gewindestange M3 auf Länge sägen; Kugelpfannen 5 mm, z. B. Tamiya) | manuell suchen |  |  |  | manuell suchen | - | - | Ersatz für das Lenkgestänge aus 54539 (Kugelmitte–Kugelmitte 96,76 mm, zu lang für 3 × 32); eine Seite mit Kontermutter zum Einstellen der Lenkungsmitte
79 | Lenkung | Druckfeder Servo-Saver d 1,2 × Da 10 × L0 20 mm, 5,5 federnde Windungen | 1 | Stk | Normteil |  | DIN 2098 / EN 13906-1 | Federstahldraht EN 10270-1 SH, d 1,2 mm, Da 10 mm, L0 20 mm, n 5,5 (nt 7,5), Federrate ca. 5,6 N/mm, Blocklänge ca. 9 mm | manuell suchen (Federnkatalog, z. B. Gutekunst, nach Maßen auswählen) | manuell suchen |  |  |  | manuell suchen | - | - | Vorspannung ca. 47 N bei Einbaulänge 11,6 mm für 0,4 Nm (Rechnung docs/vorderachse.md); Federrate 4–7 N/mm zulässig, Einbaulänge über die Vorspannschraube einstellen
80 | Lenkung | Scheiben DIN 433 M3 (Ø 6) und DIN 9021 M3 (Ø 9) | 1 | Satz | Normteil |  | DIN 433, DIN 9021 | Stahl verzinkt oder Edelstahl | manuell suchen | manuell suchen |  |  |  | manuell suchen | - | - | 2 × DIN 433 auf den Innenringen der Umlenkhebel-Lager, 1 × DIN 9021 auf der Saver-Feder; Karosseriehalter/Rammschutz: 4 × DIN 9021 M3 unter den Pufferschrauben auf dem TPU
81 | Karosseriehalter/Rammschutz | Rammschutz-Träger vorne (Fuß, Lippe an der Plattenstirn, Flansch, Balken, Mittelsteg) | 1 | Stk | Druck | Eigenbau |  | PETG (Test), Prusament PC (fertig); 4 Gewindeeinsätze M3 (Pos. 30); 2 × M3 × 8 Senkkopf von unten (Pos. 24) | print/stl/rammschutz-traeger-vorne.stl |  |  |  |  | konstruiert | 43,2 g (PETG) / 40,8 g (PC), 100 % Füllung | Fusion, Volumen × 1,27 bzw. 1,20 g/cm³ | Eigenbau, docs/karosseriehalter-rammschutz.md; Lochbild Rammschutz (169,35 / ±8) und Karosseriehalter (±22, Durchgang für die Pfostenschrauben); Druck: Balken-Vorderseite auf dem Bett, ohne Stützen
82 | Karosseriehalter/Rammschutz | Rammschutz-Träger hinten (Fuß, Balken an der Plattenstirn, Mittelsteg) | 1 | Stk | Druck | Eigenbau |  | PETG (Test), Prusament PC (fertig); 4 Gewindeeinsätze M3 (Pos. 30); 2 × M3 × 8 Senkkopf von unten (Pos. 24) | print/stl/rammschutz-traeger-hinten.stl |  |  |  |  | konstruiert | 55,8 g (PETG) / 52,8 g (PC), 100 % Füllung | Fusion, Volumen × 1,27 bzw. 1,20 g/cm³ | Eigenbau, docs/karosseriehalter-rammschutz.md; Lochbild (−169,35 / ±8; ±22); Druck: Balken-Außenseite auf dem Bett, ohne Stützen
83 | Karosseriehalter/Rammschutz | Rammschutz-Puffer vorne (Hohlprofil mit Anfahrschräge 45°) | 1 | Stk | Druck | Eigenbau |  | TPU (Annahme Shore 95A), Wand 2 mm, Federweg 5 mm; ohne Gewindeeinsätze | print/stl/rammschutz-puffer-vorne.stl |  |  |  |  | konstruiert | 18,0 g (TPU, 100 % Füllung) | Fusion, Volumen × 1,21 g/cm³ | Eigenbau, docs/karosseriehalter-rammschutz.md; 2 × M3 × 8 Zylinderkopf (Pos. 17) mit Scheibe DIN 9021 (Pos. 80) von oben in den Mittelsteg; tauschbar ohne den Träger abzuschrauben; Druck: Stoßfläche auf dem Bett
84 | Karosseriehalter/Rammschutz | Rammschutz-Puffer hinten (Hohlprofil mit Anfahrschräge 45°) | 1 | Stk | Druck | Eigenbau |  | TPU (Annahme Shore 95A), Wand 2 mm, Federweg 5 mm; ohne Gewindeeinsätze | print/stl/rammschutz-puffer-hinten.stl |  |  |  |  | konstruiert | 26,6 g (TPU, 100 % Füllung) | Fusion, Volumen × 1,21 g/cm³ | Eigenbau, docs/karosseriehalter-rammschutz.md; wie Pos. 83; Druck: Stoßfläche auf dem Bett
85 | Karosseriehalter/Rammschutz | Karosseriepfosten vorne mit Lochraster (5 Löcher, Teilung 4 mm) | 2 | Stk | Druck | Eigenbau |  | PETG (Test), Prusament PC (fertig); je 1 Gewindeeinsatz M3 (Pos. 30); 8 × 8 mm | print/stl/karosserie-pfosten-vorne.stl (2 × drucken) |  |  |  |  | konstruiert | je 6,4 g (PETG) / 6,1 g (PC) | Fusion, Volumen × 1,27 bzw. 1,20 g/cm³ | Eigenbau, docs/karosseriehalter-rammschutz.md; je 1 × M3 × 20 Senkkopf von unten (Pos. 27) durch Grundplatte und Träger; Lage und Höhe vorläufig, nach Lieferung der Karosserie messen und ggf. neu drucken; Druck: liegend
86 | Karosseriehalter/Rammschutz | Karosseriepfosten hinten mit Lochraster (5 Löcher, Teilung 4 mm) | 2 | Stk | Druck | Eigenbau |  | PETG (Test), Prusament PC (fertig); je 1 Gewindeeinsatz M3 (Pos. 30); 8 × 8 mm | print/stl/karosserie-pfosten-hinten.stl (2 × drucken) |  |  |  |  | konstruiert | je 7,3 g (PETG) / 6,9 g (PC) | Fusion, Volumen × 1,27 bzw. 1,20 g/cm³ | Eigenbau, docs/karosseriehalter-rammschutz.md; wie Pos. 85, 11 mm länger
87 | Karosserie | Karosserie Neo Scorcher (Lexan) aus dem Bausatz 58568 | 1 | Stk | Bausatz | Tamiya | Nr. laut Anleitung 58568 | Polycarbonat (Lexan), unlackiert; Lackieren, Ausschneiden und Bohren durch den Nutzer | aus Pos. 1 (Bausatz 58568) |  |  |  |  | - | Befestigungslöcher, Höhe und Hülle vorläufig (kr_karo_*, kr_hu_*) | docs/karosseriehalter-rammschutz.md (Messpunkte) | Nutzerentscheidung 2026-11-10; Lage und Höhe der Befestigungslöcher nach Lieferung messen
88 | Karosserie | Karosserieklammern (R-Klammern) aus dem Bausatz 58568 | 4 | Stk | Bausatz | Tamiya | Nr. laut Anleitung 58568 | Federstahl; Draht vorläufig Ø 1,4 mm (kr_klammer_d) | aus Pos. 1 (Bausatz 58568) |  |  |  |  | - | Drahtdurchmesser und Länge am Teil messen | docs/karosseriehalter-rammschutz.md (Messpunkte) | Annahme: liegen dem Bausatz bei; Ersatz als Zukauf nur, falls nicht (z. B. Tamiya Karosserieklammern)
