ZaphodBytebrox/open-rc-car/(list of files, cad)

Other CAD files:
cad/step/karosseriehalter-rammschutz.step
print/stl/rammschutz-puffer-vorne.stl
cad/step/chassis-grundplatte-alu.step
print/stl/rammschutz-traeger-hinten.stl
cad/step/chassis-grundplatte-oberdeck.step
print/stl/karosserie-pfosten-vorne.stl
cad/step/vorderachse.step
print/stl/karosserie-pfosten-hinten.stl
cad/step/mittelantrieb.step
print/stl/rammschutz-puffer-hinten.stl
cad/step/hinterachse.step
print/stl/rammschutz-traeger-vorne.stl
cad/step/skelett.step
print/stl/chassis-grundplatte-vorne.stl
print/stl/chassis-oberdeck.stl
print/stl/chassis-grundplatte-hinten.stl
print/stl/lenkung-achsschenkel-links.stl
print/stl/lenkung-achsschenkel-rechts.stl
print/stl/vorderachse-querlenker-links.stl
print/stl/vorderachse-frontschott.stl
print/stl/lenkung-umlenkhebel-links.stl
print/stl/lenkung-servohalter.stl
print/stl/lenkung-servo-saver-arm.stl
print/stl/lenkung-umlenkhebel-rechts.stl
print/stl/lenkung-lagerbock-rechts.stl
print/stl/vorderachse-querlenkerbock-rechts-vorne.stl
print/stl/vorderachse-daempferbruecke.stl
print/stl/vorderachse-querlenkerbock-links-vorne.stl
print/stl/vorderachse-querlenker-rechts.stl
print/stl/vorderachse-querlenkerbock-rechts-hinten.stl
print/stl/vorderachse-c-hub-rechts.stl
print/stl/vorderachse-c-hub-links.stl
print/stl/lenkung-lagerbock-links.stl
print/stl/vorderachse-querlenkerbock-links-hinten.stl
print/stl/lenkung-servo-saver-nabe.stl
print/stl/mittelantrieb-motorhalter.stl
print/stl/hinterachse-getriebegehaeuse-rechts.stl
print/stl/mittelantrieb-zahnradabdeckung-oben.stl
print/stl/hinterachse-getriebegehaeuse-links.stl
print/stl/mittelantrieb-motorplatte.stl
print/stl/mittelantrieb-zahnradabdeckung-unten-links.stl
print/stl/mittelantrieb-zahnradabdeckung-unten-rechts.stl
print/stl/mittelantrieb-blinddeckel.stl
print/stl/hinterachse-radtraeger-rechts.stl
print/stl/hinterachse-daempferbruecke.stl
print/stl/hinterachse-querlenkerbock-links-vorne.stl
print/stl/hinterachse-radtraeger-links.stl
print/stl/hinterachse-querlenker-links.stl
print/stl/hinterachse-querlenkerbock-rechts-hinten.stl
print/stl/hinterachse-querlenkerbock-links-hinten.stl
print/stl/hinterachse-getriebegehaeuse-lagerbock.stl
print/stl/hinterachse-querlenkerbock-rechts-vorne.stl
print/stl/hinterachse-querlenker-rechts.stl
print/stl/chassis-akkuanschlag-rechts.stl
print/stl/chassis-akkuanschlag-links.stl
print/stl/chassis-mittelstuetze.stl
print/stl/chassis-akkuanschlag-hinten.stl
print/stl/chassis-akkuanschlag-vorne.stl
cad/fusion/chassis-grundplatte-oberdeck.f3d
cad/fusion/hinterachse.f3d
cad/fusion/karosseriehalter-rammschutz.f3d
cad/fusion/mittelantrieb.f3d
cad/fusion/skelett.f3d
cad/fusion/vorderachse.f3d
