ZaphodBytebrox/open-rc-car/(commit log)

2026-10-26 Projektgrundlagen: Struktur, Lizenz, Plan und Anforderungsanalyse
    - Ordnerstruktur für CAD, Druckdateien, Elektronik, Stückliste und Doku
    - Git LFS für CAD-, Druck- und Bilddateien (.gitattributes), .gitignore
    - Lizenzen: CERN-OHL-S v2 (Hardware), CC BY-SA 4.0 (Dokumentation)
    - README.md und AGENTS.md mit Git-Workflow (ein PR pro Anforderung, ein Commit pro PR)
    - CLAUDE.md verweist auf AGENTS.md
    - Grobplan (docs/plan.md) und Anforderungen Gesamtfahrzeug (docs/anforderungen/fahrzeug.md)
    - Skill "anforderungsanalyse" für mechanisches und elektronisches Design
    - Fusion-MCP-Konfiguration (.mcp.json)
    Claude-Session: https://claude.ai/co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
    [stueckliste.csv]
2026-10-26 Skills für den Ablauf von Anforderungen: umsetzung, review, neue-anforderung
    - Neuer Skill .claude/skills/umsetzung: setzt Anforderungsdokumente aus
    docs/anforderungen/ um (Mechanik in Fusion über MCP, Elektronik in
    KiCad über MCP, Firmware), mit Nachweis je Anforderung, Stückliste und PR
    - Neuer Skill .claude/skills/review: unabhängiges, nur lesendes Review
    eines PR gegen Anforderungen, Fusion-Modell, KiCad (eigener ERC/DRC)
    und AGENTS.md; Befunde nach Schwere
    - Neuer Skill .claude/skills/neue-anforderung: steuert den ganzen Ablauf
    (Analyse, Freigabe durch den Nutzer, dann Umsetzung, Review und
    Einarbeitung in eigenen Agenten, höchstens 5 Durchläufe)
    - Elektronik: KiCad 1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
2026-10-26 KiCad-MCP-Server einrichten: kicad-mcp-pro
    - .mcp.json: Server `kicad` (kicad-mcp-pro 4.4.0 über uvx, Profil builder, Modus write)
    - AGENTS.md: Server, Voraussetzungen und IPC-API beschrieben
    - docs/plan.md: Entscheidung für kicad-mcp-pro mit verworfenen Alternativen
    - Skill umsetzung: Projekt zuerst mit kicad_set_project setzen
    Claude-Session: https://claude.ai/code/session_011kT3gfdJGpRA8tesAxgRnZ
2026-10-27 Zukaufteile v1: Spenderplattform, Shops und Stückliste
    Spenderplattform TLR 22X-4 (Elite-Ersatzteile) nach Vergleich mit
    RC10B74.2 und XRAY XB4. Bezug bei Horizon Hobby EU, Modellbau Lindinger
    und RC Team. Stückliste mit Teilenummern, Links, Preisen und Maßen,
    Rechnungen zu Geschwindigkeit und Federweg, Plan aktualisiert.
    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
    [stueckliste.csv]
2026-10-27 Skelettmodell des Fahrzeugs in Fusion
    Parametrisches Skelett mit 145 Benutzerparametern, Radpositionen mit
    Bewegungsraum (Federweg und Lenkeinschlag), schrägen Antriebswellen mit
    Bewegungsraum für Wellen und Radachsen, Hüllkörpern aller räumlich
    relevanten Zukaufteile, 4WD-Bauraum, Zahnradabdeckung und zweiteiliger
    Grundplatte. Massen über das ganze Design (Räder vorläufig 100 g).
    Ergebnis: alles passt (53 gewollte Überschneidungen), Grundplatte
    335,5 x 154 mm, Teilung bei X = 50 mm (Teile 232,75 und 132,75 mm lang),
    Schwerpunkt quer 0,32 mm.
    Setzt MECH-SKE-001 bis -016, DOC-SKE-001 bis -003 und MECH-FZG-002 um.
    Claude-Sessio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
    [skelett.f3d, skelett.step]
2026-10-28 Zukaufteile v1: Plattformwechsel auf Tamiya TT-02B
    Spenderplattform von TLR 22X-4 auf Tamiya TT-02B umgestellt (günstiger
    Einstieg, Bausatz Neo Scorcher 58568 als Teilespender). Anforderungen
    ZUK Fassung 2, Stückliste, Ergebnisdokument, Plan und MECH-FZG-005
    angepasst.
    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
    [stueckliste.csv]
2026-10-31 Skelett auf Tamiya TT-02B umgestellt
    Fassung 2 des Skelettmodells (MECH-SKE-001 bis -018, DOC-SKE-001 bis -003):
    TT-02B-Maße und -Layout, Kardanwelle E1 nur an den Getrieben gelagert,
    Hauptzahnrad mit eigener Rutschkupplung auf der hinteren Kegelritzelwelle,
    Motor hinten rechts mit Bauraum für den Motorhalter, Bauraum für Ritzel
    16Z bis 25Z. Grundplatte 314 x 132 mm, Teilung bei X = 0.
    Design-Version 10, Exporte f3d und STEP.
    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
    [skelett.f3d, skelett.step]
2026-10-31 Grundplatte und Oberdeck auf dem TT-02B-Skelett (Fassung 2)
    Fusion-Design „open-rc-car-grundplatte“ als neue Version auf dem
    Skelett neu aufgebaut: Grundplatte 344 × 144 mm mit Verlängerung
    vorne und hinten, für den Druck zweiteilig mit Stoß bei X −15…15 und
    einteilige Aluvariante mit identischen 107 Lochbildern; Querlenkerböcke
    neben den Getrieben und Lagerböcke des Lenkhebelsystems als reservierte
    Fußflächen; Oberdeck auf beiden Getrieben und der neuen Mittelstütze,
    die den Stoß klemmt; Akkuanschläge, Elektronik-Raster, Erleichterungs-
    taschen. Exporte, Stückliste, Schnittstellenblatt und Plan aktualisiert
    (MECH-CHA-001 bis -022, DOC-CHA-001/-002).
    Review 1: Parametert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
    [chassis-akkuanschlag-hinten.stl, chassis-akkuanschlag-links.stl, chassis-akkuanschlag-rechts.stl, chassis-akkuanschlag-vorne.stl, chassis-grundplatte-alu.step, chassis-grundplatte-hinten.stl, chassis-grundplatte-oberdeck.f3d, chassis-grundplatte-oberdeck.step]
2026-11-01 Hinterachse: Getriebegehäuse, Querlenker, Radträger und Dämpferbrücke
    Neues Fusion-Design „open-rc-car-hinterachse“ (v11), abgeleitet von
    Skelett v14 (maßgleich v12) und Grundplatte v11: zweiteiliges Getriebe-
    und Differentialgehäuse für das TT-02B-Diff mit Kegelritzelwelle E2 und
    abnehmbarem Lagerbock für das vordere E2-Lager (Lagerung wie
    Bauanleitung, Hauptzahnrad zwischen den Lagern), vier
    Querlenkerböcke, untere Querlenker, Radträger mit fester Vorspur,
    Sturzstangen (Zukauf 54539) und Dämpferbrücke hinter dem Gehäuse.
    Hüllkörper für Diff, Tellerrad, Kegelritzelwelle und den Zahnradraum
    zwischen den E2-Lagern. Aufhängung über ha_ql_dphi beweglich,
    Bewegungsprüfung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
    [hinterachse-daempferbruecke.stl, hinterachse-getriebegehaeuse-lagerbock.stl, hinterachse-getriebegehaeuse-links.stl, hinterachse-getriebegehaeuse-rechts.stl, hinterachse-querlenker-links.stl, hinterachse-querlenker-rechts.stl, hinterachse-querlenkerbock-links-hinten.stl, hinterachse-querlenkerbock-links-vorne.stl]
2026-11-02 Mittelantrieb: Motorhalter, Motorplatte mit Becherhaube und Zahnradabdeckung
    Neues Fusion-Design open-rc-car-mittelantrieb (v9): Motorhalter als
    Vorderwand der Zahnradabdeckung, Motorplatte mit radialer
    Zahnspiel-Einstellung (20Z-25Z) und Becherhaube (Motordose als Wand),
    dreiteilige Zahnradabdeckung, Blinddeckel fuer die E1-Oeffnung.
    Hinterachse v12/v13: Freischnitt fuer das Ritzel an der Gehaeusetrommel,
    Schnittstellenparameter als Favoriten. Doku, Stueckliste und Plan
    nachgezogen.
    Review 1 eingearbeitet: Rueckwand an der oberen Gehaeuseschraube 1,2 mm
    mit Schlitz fuer den Schraubenkopf, Ringspalt an den Lagerbock-Schrauben
    0,5 mm (Engstelle im Halter, Abdeckung, Bodenleiste), Halterwand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
    [hinterachse-getriebegehaeuse-links.stl, hinterachse-getriebegehaeuse-rechts.stl, hinterachse.f3d, hinterachse.step, mittelantrieb-blinddeckel.stl, mittelantrieb-motorhalter.stl, mittelantrieb-motorplatte.stl, mittelantrieb-zahnradabdeckung-oben.stl]
2026-11-08 Vorderachse und Lenkung: Frontschott, Querlenker, Achsschenkel, Lenkhebelsystem mit Servo-Saver, Servohalter
    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
    [lenkung-achsschenkel-links.stl, lenkung-achsschenkel-rechts.stl, lenkung-lagerbock-links.stl, lenkung-lagerbock-rechts.stl, lenkung-servo-saver-arm.stl, lenkung-servo-saver-nabe.stl, lenkung-servohalter.stl, lenkung-umlenkhebel-links.stl]
2026-11-13 Grundplatte: Überstand 20 mm, Lochreihe Rammschutz/Karosseriehalter verlegt
    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
    [chassis-grundplatte-alu.step, chassis-grundplatte-hinten.stl, chassis-grundplatte-oberdeck.f3d, chassis-grundplatte-oberdeck.step, chassis-grundplatte-vorne.stl, chassis-oberdeck.stl, stueckliste.csv]
2026-11-13 Karosseriehalter und Rammschutz: Träger, TPU-Puffer und Karosseriepfosten
    Neues Fusion-Design „open-rc-car-karosseriehalter-rammschutz“ (v4),
    abgeleitet von Skelett v16, Grundplatte v12, Vorderachse v8 und
    Hinterachse v14. Rammschutz vorne und hinten aus PC-Träger mit Anlage
    an der Plattenstirn und TPU-Hohlprofil (Federweg 5 mm, 45°-Schräge),
    Gesamtlänge 379,6 mm. Karosseriepfosten mit Lochraster (±8 mm) auf dem
    Karosseriehalter-Lochbild, vorläufige Karosseriehülle Neo Scorcher.
    Skelett v15/v16 für den Radstand-Test (v16 maßgleich mit v14).
    Exporte f3d, STEP, 6 STL; Stückliste, Plan und Doku aktualisiert.
    Claude-Session: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
    [karosserie-pfosten-hinten.stl, karosserie-pfosten-vorne.stl, karosseriehalter-rammschutz.f3d, karosseriehalter-rammschutz.step, rammschutz-puffer-hinten.stl, rammschutz-puffer-vorne.stl, rammschutz-traeger-hinten.stl, rammschutz-traeger-vorne.stl]
